alexanderjgshort/SoftDrone/hardware/Components/ANT_916_HETH_3D/ANT-916-HETH.STEP

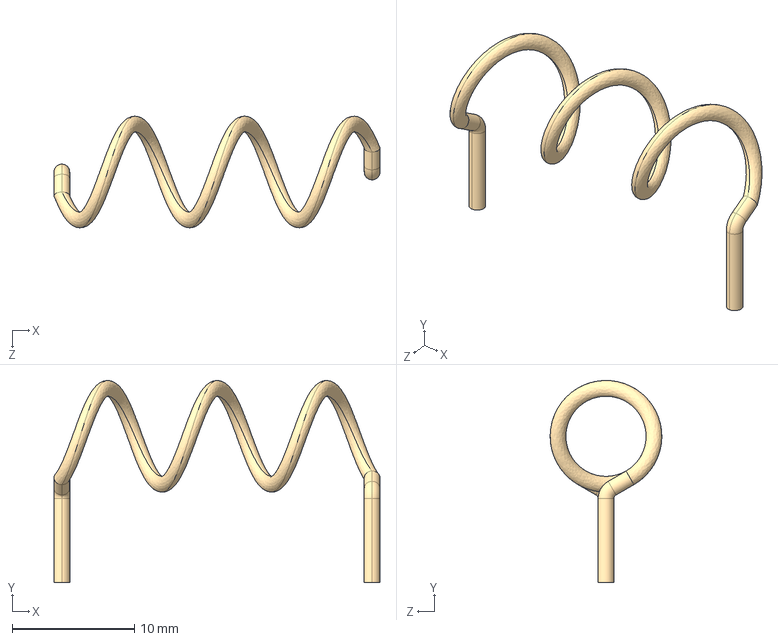
[picture p1: CAD file, 2026-09-10]
hardware/Components/ANT_916_HETH_3D/ANT-916-HETH.STEP
26.7 x 16.5 x 9.14 mm
