alexanderjgshort/SoftDrone/hardware/Components/F330 low plate(1)/F330 low plate - Part 1.step

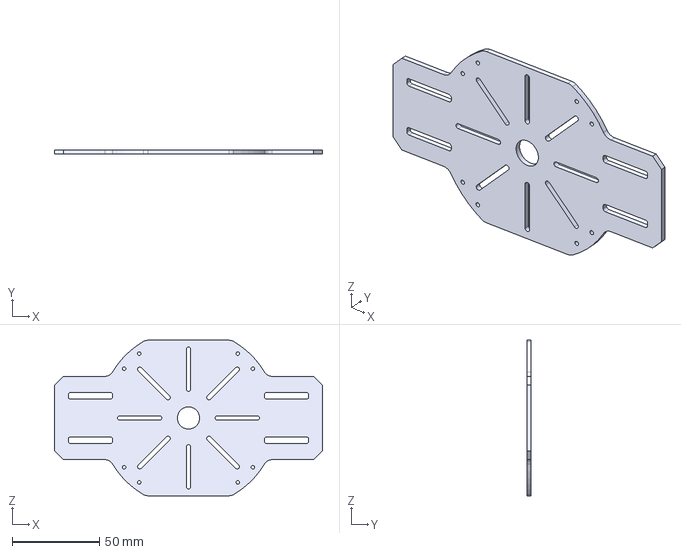
[picture p2: CAD file, 2026-09-12]
hardware/Components/F330 low plate(1)/F330 low plate - Part 1.step
153.2 x 2.54 x 88.9 mm
