alexanderjgshort/SoftDrone/hardware/Components/HRO_TYPE-C-31-M-12.step

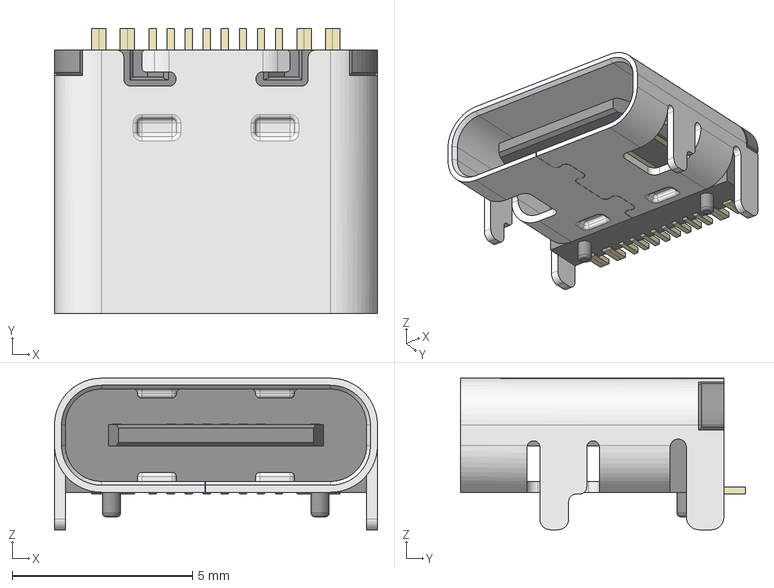
[picture p3: CAD file, 2026-09-13]
hardware/Components/HRO_TYPE-C-31-M-12.step
8.95 x 7.90 x 4.20 mm
