alexanderjgshort/SoftDrone/hardware/Components/LIB_6DFN36CA-M3_I/6DFN36CA-M3_I/3D/6DFN36CA-M3_I.stp

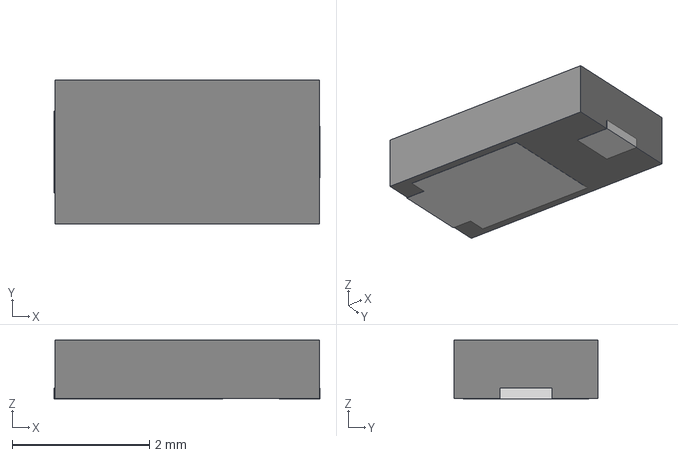
[picture p4: CAD file, 2026-09-13]
hardware/Components/LIB_6DFN36CA-M3_I/6DFN36CA-M3_I/3D/6DFN36CA-M3_I.stp
3.87 x 2.10 x 0.854 mm
