alexanderjgshort/SoftDrone/hardware/Components/LIB_ANT-916-HETH/ANT-916-HETH/3D/ANT-916-HETH.stp

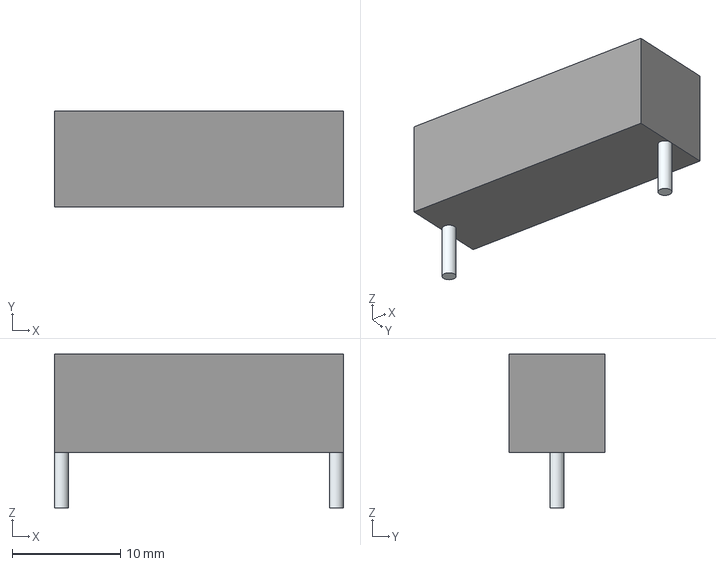
[picture p5: CAD file, 2026-09-09]
hardware/Components/LIB_ANT-916-HETH/ANT-916-HETH/3D/ANT-916-HETH.stp
26.7 x 8.90 x 14.2 mm
Leads
