alexanderjgshort/SoftDrone/hardware/Components/LIB_ANT-DB1-NSP250-T/ANT-DB1-NSP250-T/3D/ANT-DB1-NSP250-T.stp

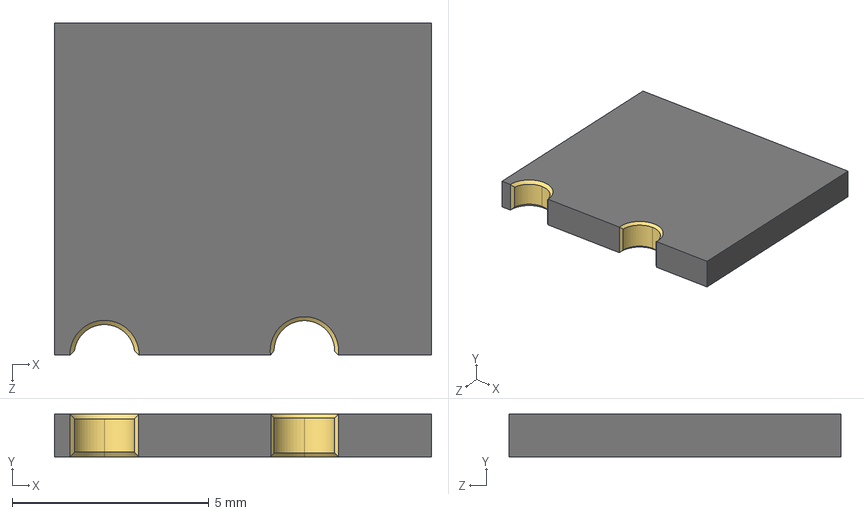
[picture p6: CAD file, 2026-09-09]
hardware/Components/LIB_ANT-DB1-NSP250-T/ANT-DB1-NSP250-T/3D/ANT-DB1-NSP250-T.stp
9.58 x 1.09 x 8.43 mm
