alexanderjgshort/SoftDrone/hardware/Components/LIB_BM08B-SRSS-TB_LF__SN_/BM08B-SRSS-TB_LF__SN_/3D/BM08B-SRSS-TB_LF__SN_.stp

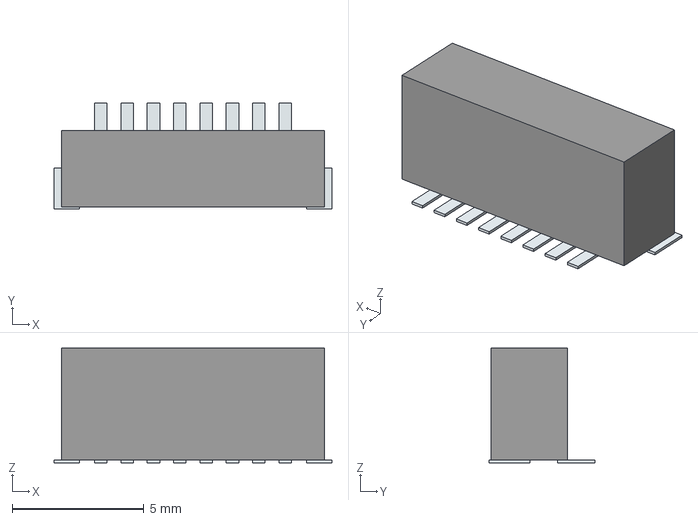
[picture p7: CAD file, 2026-09-04]
hardware/Components/LIB_BM08B-SRSS-TB_LF__SN_/BM08B-SRSS-TB_LF__SN_/3D/BM08B-SRSS-TB_LF__SN_.stp
10.6 x 4.02 x 4.35 mm
Pins
