alexanderjgshort/SoftDrone/hardware/Components/LIB_BMP581/BMP581/3D/BMP581.stp

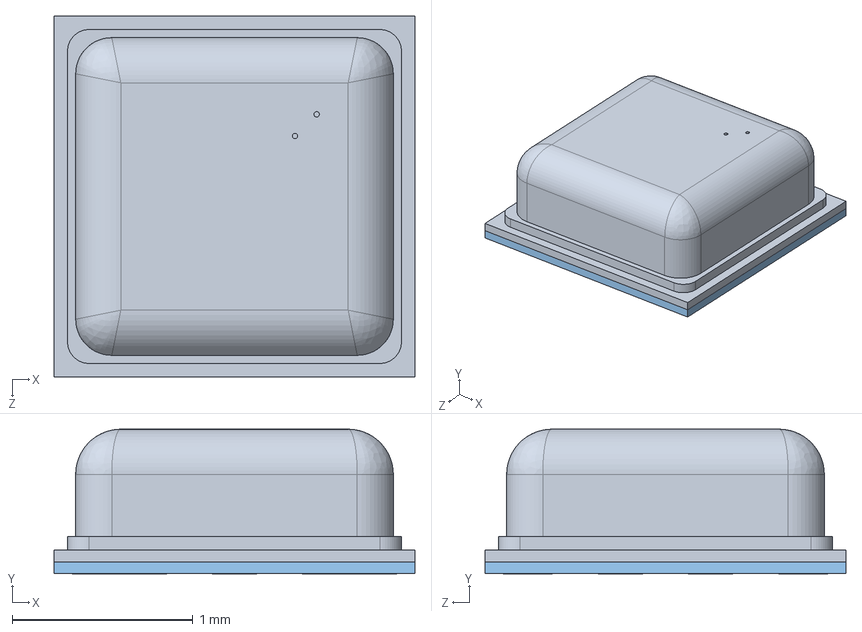
[picture p8: CAD file, 2026-09-04]
hardware/Components/LIB_BMP581/BMP581/3D/BMP581.stp
2.00 x 0.801 x 2.00 mm
