alexanderjgshort/SoftDrone/hardware/Components/LIB_CC3350ENJARSBR/CC3350ENJARSBR/3D/CC3350ENJARSBR.stp

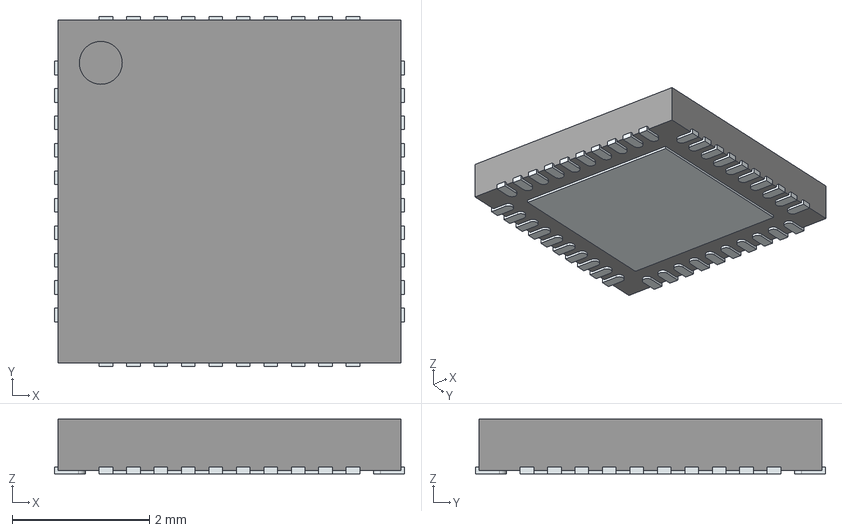
[picture p9: CAD file, 2026-09-03]
hardware/Components/LIB_CC3350ENJARSBR/CC3350ENJARSBR/3D/CC3350ENJARSBR.stp
5.10 x 5.10 x 0.8 mm
ThermalPin
PinsArrayLR
PinsArrayTB
