alexanderjgshort/SoftDrone/hardware/Components/LIB_ECMF2-40A100N6/ECMF2-40A100N6/3D/ECMF2-40A100N6.stp

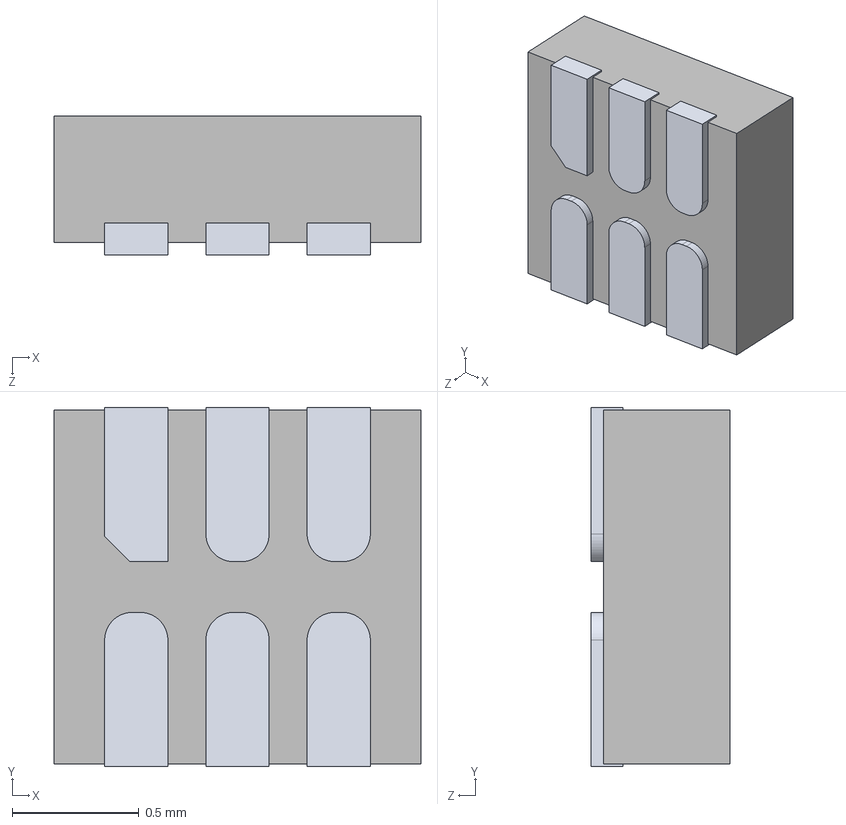
[picture p10: CAD file, 2026-09-08]
hardware/Components/LIB_ECMF2-40A100N6/ECMF2-40A100N6/3D/ECMF2-40A100N6.stp
1.45 x 1.42 x 0.55 mm
