alexanderjgshort/SoftDrone/hardware/Components/LIB_FC-135R_32.7680KA-A3/FC-135R_32.7680KA-A3/3D/FC-135R_32.7680KA-A3.stp

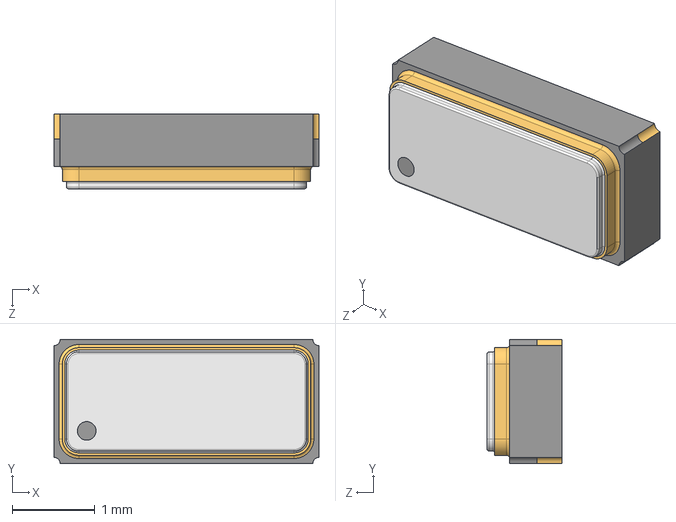
[picture p11: CAD file, 2026-09-24]
hardware/Components/LIB_FC-135R_32.7680KA-A3/FC-135R_32.7680KA-A3/3D/FC-135R_32.7680KA-A3.stp
3.20 x 1.50 x 0.9 mm
