alexanderjgshort/SoftDrone/hardware/Components/LIB_ICM-42688-P/ICM-42688-P/3D/ICM-42688-P.stp

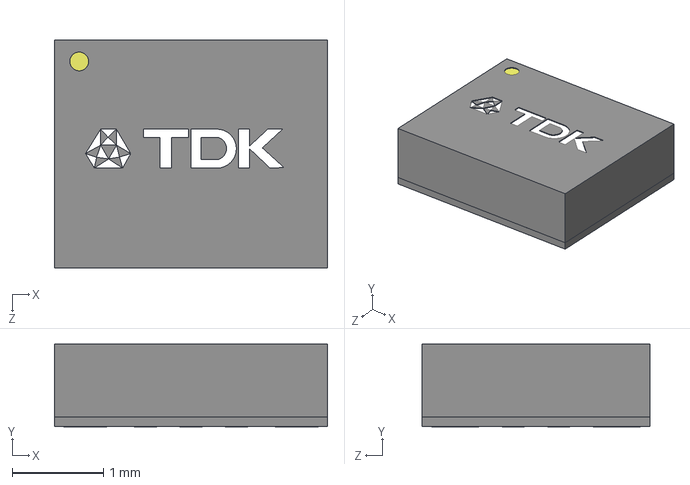
[picture p12: CAD file, 2026-09-03]
hardware/Components/LIB_ICM-42688-P/ICM-42688-P/3D/ICM-42688-P.stp
3.00 x 0.91 x 2.50 mm
