alexanderjgshort/SoftDrone/hardware/Components/LIB_LM4670ITL_NOPB/LM4670ITL_NOPB/3D/LM4670ITL_NOPB.stp

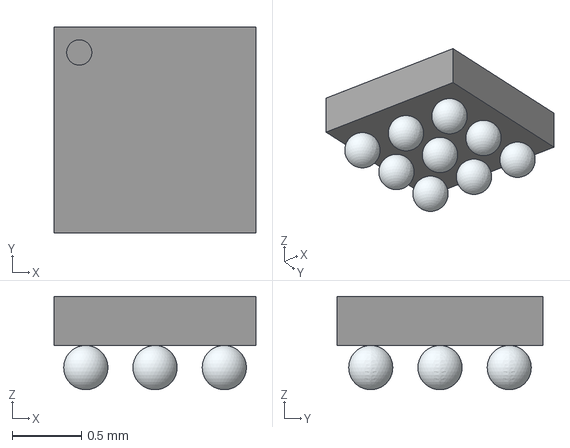
[picture p13: CAD file, 2026-09-09]
hardware/Components/LIB_LM4670ITL_NOPB/LM4670ITL_NOPB/3D/LM4670ITL_NOPB.stp
1.46 x 1.48 x 0.675 mm
