alexanderjgshort/SoftDrone/hardware/Components/LIB_LP5907A28YKMR/LP5907A28YKMR/3D/LP5907A28YKMR.stp

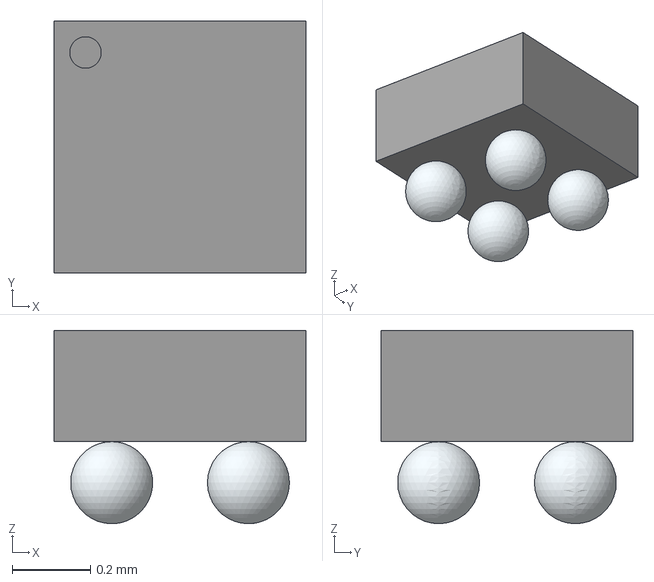
[picture p14: CAD file, 2026-09-08]
hardware/Components/LIB_LP5907A28YKMR/LP5907A28YKMR/3D/LP5907A28YKMR.stp
0.645 x 0.645 x 0.495 mm
