alexanderjgshort/SoftDrone/hardware/Components/LIB_MM8030-2610RJ3/MM8030-2610RJ3/3D/MM8030-2610RJ3.stp

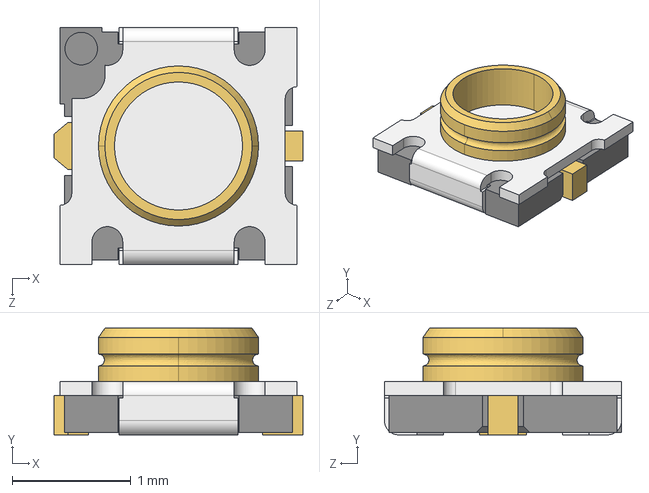
[picture p15: CAD file, 2026-09-07]
hardware/Components/LIB_MM8030-2610RJ3/MM8030-2610RJ3/3D/MM8030-2610RJ3.stp
2.10 x 0.9 x 2.00 mm
