alexanderjgshort/SoftDrone/hardware/Components/LIB_MX25UW25645GXDI00-TR/MX25UW25645GXDI00-TR/3D/MX25UW25645GXDI00-TR.stp

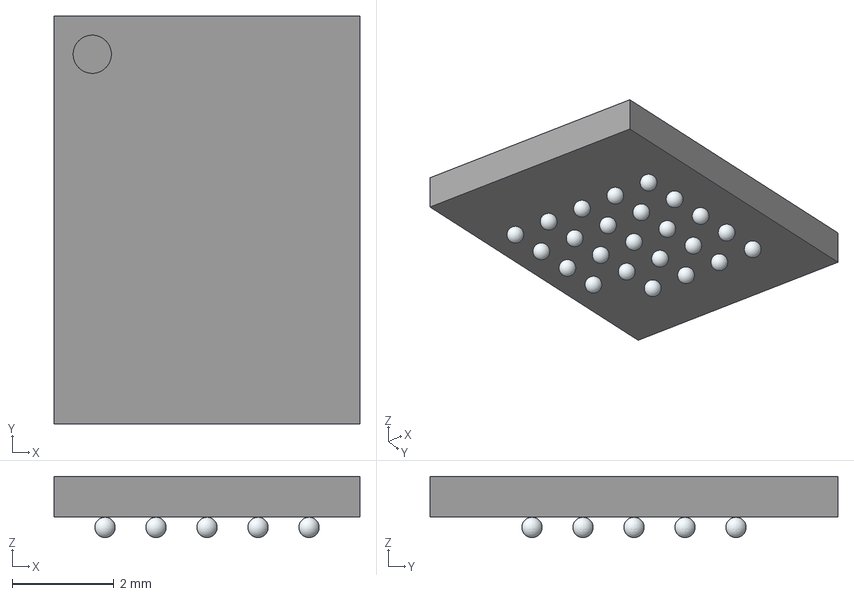
[picture p16: CAD file, 2026-09-02]
hardware/Components/LIB_MX25UW25645GXDI00-TR/MX25UW25645GXDI00-TR/3D/MX25UW25645GXDI00-TR.stp
6.00 x 8.00 x 1.20 mm
A2
A3
A4
A5
B1
B2
B3
B4
B5
C1
C2
C3
C4
C5
D1
D2
D3
D4
D5
E1
E2
E3
E4
E5
