alexanderjgshort/SoftDrone/hardware/Components/LIB_PE4259-63/PE4259-63/3D/PE4259-63.stp

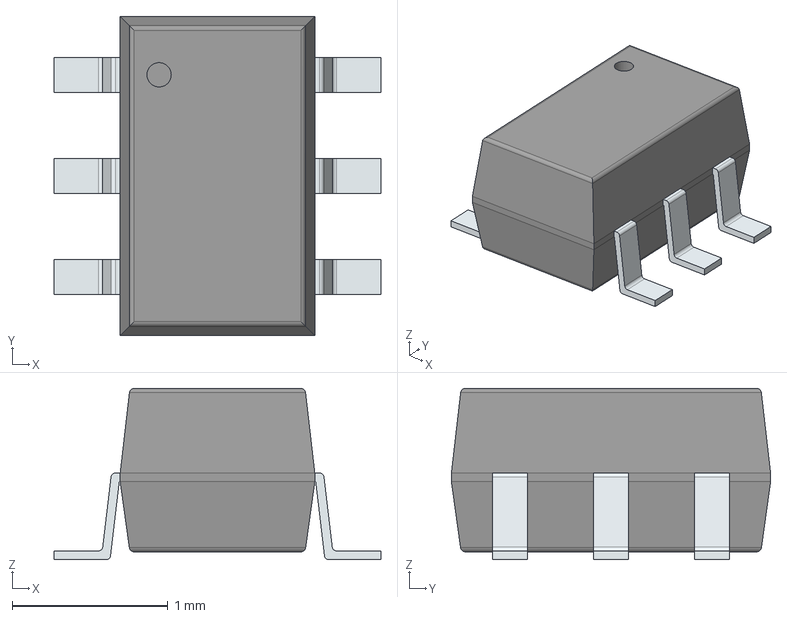
[picture p17: CAD file, 2026-09-08]
hardware/Components/LIB_PE4259-63/PE4259-63/3D/PE4259-63.stp
2.10 x 2.05 x 1.10 mm
PinsArrayLR
