alexanderjgshort/SoftDrone/hardware/Components/LIB_SAM-M10Q/SAM-M10Q/3D/SAM-M10Q.stp

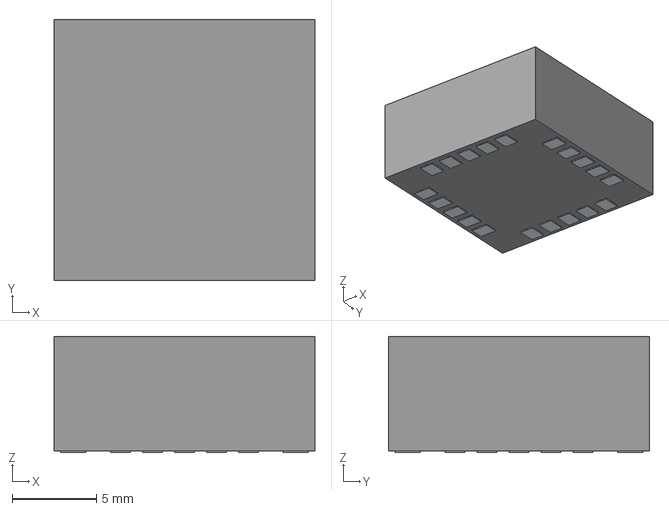
[picture p18: CAD file, 2026-09-03]
hardware/Components/LIB_SAM-M10Q/SAM-M10Q/3D/SAM-M10Q.stp
15.5 x 15.5 x 6.90 mm
Pins
