alexanderjgshort/SoftDrone/hardware/Components/LIB_SQA411CEJW-T1_GE3/SQA411CEJW-T1_GE3/3D/SQA411CEJW-T1_GE3.stp

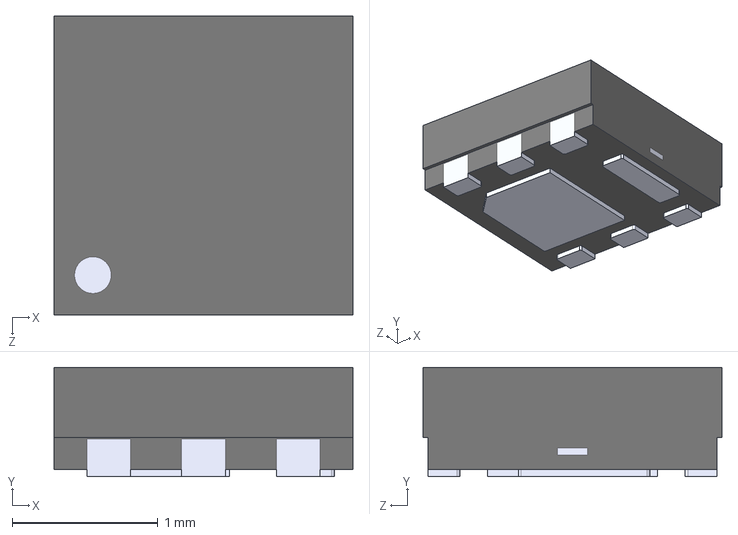
[picture p19: CAD file, 2026-09-11]
hardware/Components/LIB_SQA411CEJW-T1_GE3/SQA411CEJW-T1_GE3/3D/SQA411CEJW-T1_GE3.stp
2.05 x 0.75 x 2.05 mm
