alexanderjgshort/SoftDrone/hardware/Components/LIB_STM32N645I0H3Q/STM32N645I0H3Q/3D/STM32N645I0H3Q.stp

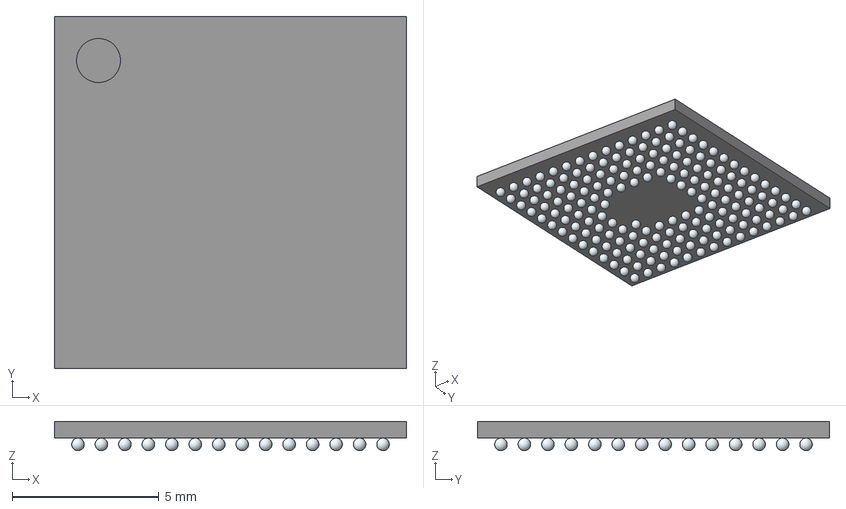
[picture p20: CAD file, 2026-09-01]
hardware/Components/LIB_STM32N645I0H3Q/STM32N645I0H3Q/3D/STM32N645I0H3Q.stp
12.0 x 12.0 x 1.00 mm
A1
A2
A3
A4
A5
A6
A7
A8
A9
A10
A11
A12
A13
A14
B1
B2
B3
B4
B5
B6
B7
B8
B9
B10
B11
B12
B13
B14
C1
C2
C3
C4
C5
C6
C7
C8
C9
C10
C11
C12
C13
C14
D1
D2
D3
D4
D5
D6
D7
D8
D9
D10
D11
D12
D13
D14
E1
E2
E3
E4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
