alexanderjgshort/SoftDrone/hardware/Components/LIB_SX1262IMLTRT/SX1262IMLTRT/3D/SX1262IMLTRT.stp

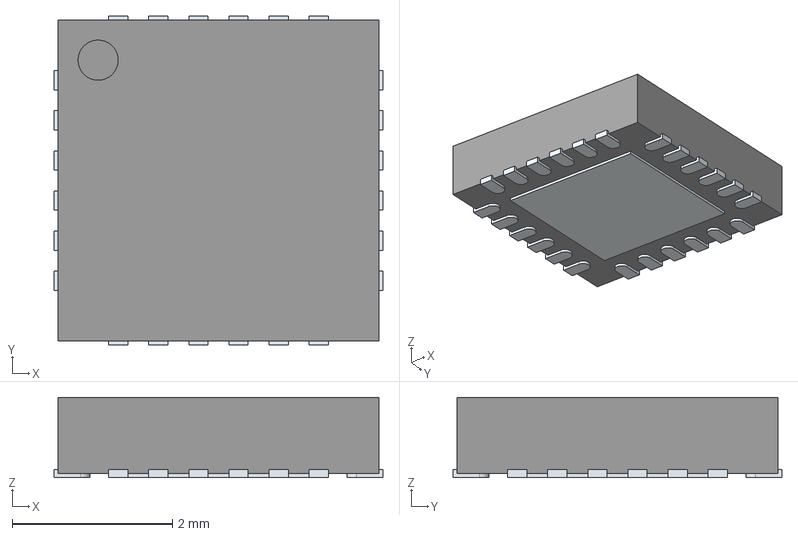
[picture p21: CAD file, 2026-09-10]
hardware/Components/LIB_SX1262IMLTRT/SX1262IMLTRT/3D/SX1262IMLTRT.stp
4.10 x 4.10 x 1.00 mm
ThermalPin
PinsArrayLR
PinsArrayTB
