alexanderjgshort/SoftDrone/hardware/Components/LIB_TPS2121RUXT/TPS2121RUXT/3D/TPS2121RUXT.stp

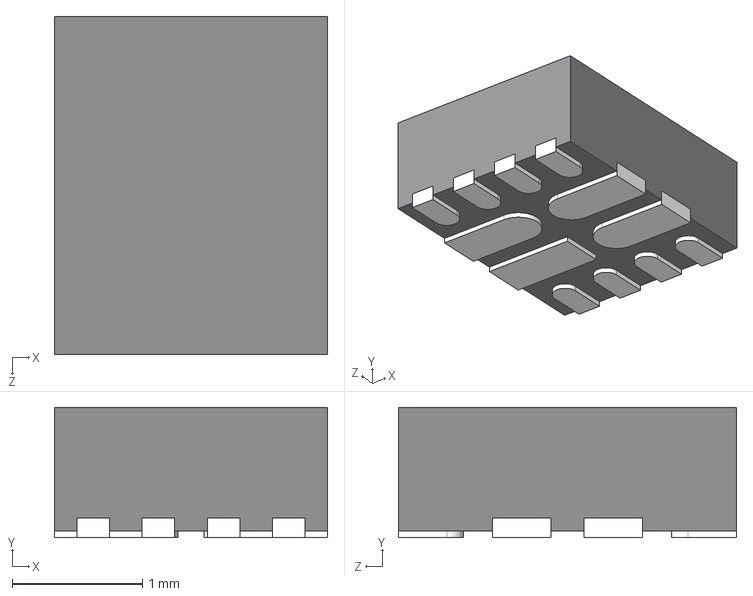
[picture p22: CAD file, 2026-09-08]
hardware/Components/LIB_TPS2121RUXT/TPS2121RUXT/3D/TPS2121RUXT.stp
2.10 x 1.00 x 2.60 mm
