alexanderjgshort/SoftDrone/hardware/Components/LIB_TXU0204BQAR/TXU0204BQAR/3D/TXU0204BQAR.stp

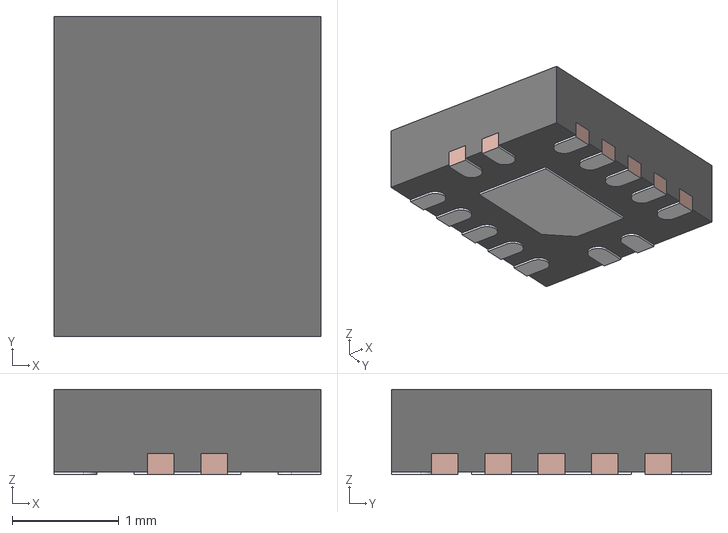
[picture p23: CAD file, 2026-09-08]
hardware/Components/LIB_TXU0204BQAR/TXU0204BQAR/3D/TXU0204BQAR.stp
2.50 x 3.00 x 0.8 mm
FRAME
