alexanderjgshort/SoftDrone/hardware/Components/ul_TPS628303ARZER_CAD/RZE0008A.stp

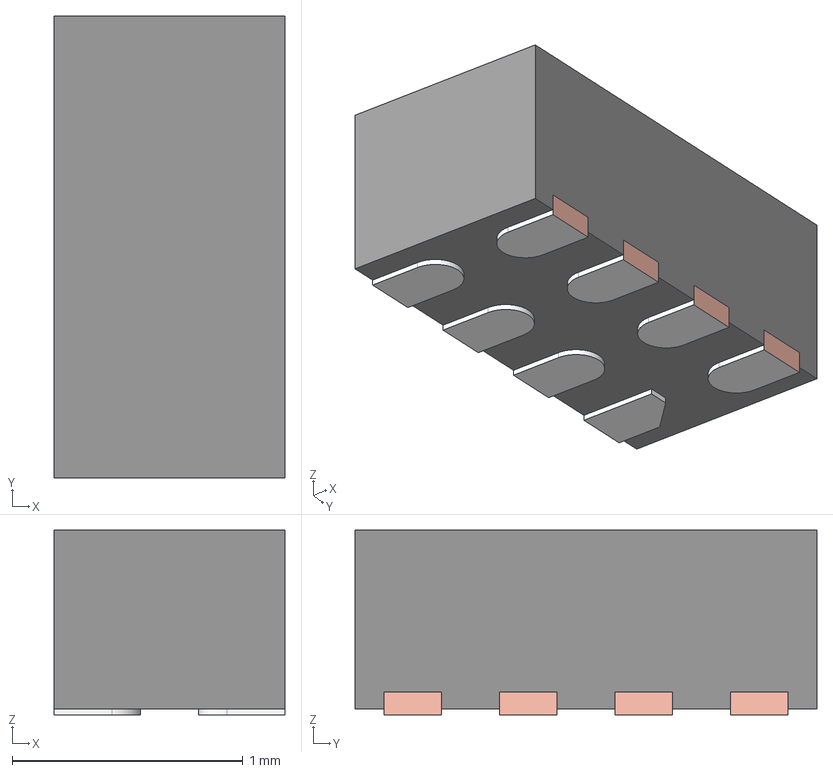
[picture p24: CAD file, 2026-09-08]
hardware/Components/ul_TPS628303ARZER_CAD/RZE0008A.stp
1.00 x 2.00 x 0.8 mm
BODY-RZE0008A
FRAME-RZE0008A
