alexanderjgshort/SoftDrone/(list of files, cad)

Other CAD files:
hardware/Components/LIB_54548-2272/54548-2272/3D/54548-2272.stp
hardware/Components/LIB_54548-2272/54548-2272/Allegro/545482272.psm
hardware/Components/LIB_54548-2272/54548-2272/DEHDL/54548_2272/chips/chips.prt
hardware/Components/LIB_6DFN36CA-M3_I/6DFN36CA-M3_I/Allegro/ss5n42hm3i.psm
hardware/Components/LIB_6DFN36CA-M3_I/6DFN36CA-M3_I/DEHDL/6dfn36ca_m3_i/chips/chips.prt
hardware/Components/LIB_74439324033/74439324033/3D/74439324033.stp
hardware/Components/LIB_74439324033/74439324033/Allegro/74439324033.psm
hardware/Components/LIB_74439324033/74439324033/DEHDL/74439324033/chips/chips.prt
hardware/Components/LIB_ANT-916-HETH/ANT-916-HETH/Allegro/ant916heth.psm
hardware/Components/LIB_ANT-916-HETH/ANT-916-HETH/DEHDL/ant_916_heth/chips/chips.prt
hardware/Components/LIB_BM08B-SRSS-TB_LF__SN_/BM08B-SRSS-TB_LF__SN_/Allegro/bm08bsrsstblfsn.psm
hardware/Components/LIB_BM08B-SRSS-TB_LF__SN_/BM08B-SRSS-TB_LF__SN_/DEHDL/bm08b_srss_tb_lf__sn_/chips/chips.prt
hardware/Components/LIB_BMP581/BMP581/Allegro/bmp581.psm
hardware/Components/LIB_BMP581/BMP581/DEHDL/bmp581/chips/chips.prt
hardware/Components/LIB_CC3350ENJARSBR/CC3350ENJARSBR/Allegro/qfn40p500x500x80-41n-d.psm
hardware/Components/LIB_CC3350ENJARSBR/CC3350ENJARSBR/DEHDL/cc3350enjarsbr/chips/chips.prt
hardware/Components/LIB_DEA162450BT-1295A1/DEA162450BT-1295A1/3D/DEA162450BT-1295A1.stp
hardware/Components/LIB_DEA162450BT-1295A1/DEA162450BT-1295A1/Allegro/dea162450bt1295a1.psm
hardware/Components/LIB_DEA162450BT-1295A1/DEA162450BT-1295A1/DEHDL/dea162450bt_1295a1/chips/chips.prt
hardware/Components/LIB_DPX167125DT-8197B1/DPX167125DT-8197B1/3D/DPX167125DT-8197B1.stp
hardware/Components/LIB_DPX167125DT-8197B1/DPX167125DT-8197B1/Allegro/dpx167125dt8197b1.psm
hardware/Components/LIB_DPX167125DT-8197B1/DPX167125DT-8197B1/DEHDL/dpx167125dt_8197b1/chips/chips.prt
hardware/Components/LIB_ECMF2-40A100N6/ECMF2-40A100N6/Allegro/ecmf240a100n6.psm
hardware/Components/LIB_ECMF2-40A100N6/ECMF2-40A100N6/DEHDL/ecmf2_40a100n6/chips/chips.prt
hardware/Components/LIB_FC-135R_32.7680KA-A3/FC-135R_32.7680KA-A3/Allegro/fc135r327680kaa3.psm
hardware/Components/LIB_FC-135R_32.7680KA-A3/FC-135R_32.7680KA-A3/DEHDL/fc_135r_32.7680ka_a3/chips/chips.prt
hardware/Components/LIB_ICM-42688-P/ICM-42688-P/Allegro/iim42352.psm
hardware/Components/LIB_ICM-42688-P/ICM-42688-P/DEHDL/icm_42688_p/chips/chips.prt
hardware/Components/LIB_LM4670ITL_NOPB/LM4670ITL_NOPB/Allegro/bga9c50p3x3_146x148x68.psm
hardware/Components/LIB_LM4670ITL_NOPB/LM4670ITL_NOPB/DEHDL/lm4670itl_nopb/chips/chips.prt
hardware/Components/LIB_LM4670SD_NOPB/LM4670SD_NOPB/Allegro/son50p300x300x80-9n.psm
hardware/Components/LIB_LM4670SD_NOPB/LM4670SD_NOPB/DEHDL/lm4670sd_nopb/chips/chips.prt
hardware/Components/LIB_LP5907A28YKMR/LP5907A28YKMR/Allegro/bga4c35p2x2_64x64x50.psm
hardware/Components/LIB_LP5907A28YKMR/LP5907A28YKMR/DEHDL/lp5907a28ykmr/chips/chips.prt
hardware/Components/LIB_MM8030-2610RJ3/MM8030-2610RJ3/Allegro/mm80302610rj3.psm
hardware/Components/LIB_MM8030-2610RJ3/MM8030-2610RJ3/DEHDL/mm8030_2610rj3/chips/chips.prt
hardware/Components/LIB_MX25UW25645GXDI00-TR/MX25UW25645GXDI00-TR/Allegro/bga24c100p5x5_600x800x120.psm
hardware/Components/LIB_MX25UW25645GXDI00-TR/MX25UW25645GXDI00-TR/DEHDL/mx25uw25645gxdi00_tr/chips/chips.prt
hardware/Components/LIB_PE4259-63/PE4259-63/Allegro/sot65p210x110-6n.psm
hardware/Components/LIB_PE4259-63/PE4259-63/DEHDL/pe4259_63/chips/chips.prt
hardware/Components/LIB_SAM-M10Q/SAM-M10Q/Allegro/samm10q.psm
hardware/Components/LIB_SAM-M10Q/SAM-M10Q/DEHDL/sam_m10q/chips/chips.prt
hardware/Components/LIB_SQA411CEJW-T1_GE3/SQA411CEJW-T1_GE3/Allegro/sqa411cejwt1_ge3.psm
hardware/Components/LIB_SQA411CEJW-T1_GE3/SQA411CEJW-T1_GE3/DEHDL/sqa411cejw_t1_ge3/chips/chips.prt
hardware/Components/LIB_STM32N645I0H3Q/STM32N645I0H3Q/Allegro/bga178c80p14x14_1200x1200x100.psm
hardware/Components/LIB_STM32N645I0H3Q/STM32N645I0H3Q/DEHDL/stm32n645i0h3q/chips/chips.prt
hardware/Components/LIB_SX1262IMLTRT/SX1262IMLTRT/Allegro/qfn50p400x400x100-25n-d.psm
hardware/Components/LIB_SX1262IMLTRT/SX1262IMLTRT/DEHDL/sx1262imltrt/chips/chips.prt
hardware/Components/LIB_TAC5112IRGER/TAC5112IRGER/Allegro/tac5112irger.psm
hardware/Components/LIB_TAC5112IRGER/TAC5112IRGER/DEHDL/tac5112irger/chips/chips.prt
hardware/Components/LIB_TFM201610ALC-R47MTAA/TFM201610ALC-R47MTAA/3D/TFM201610ALC-R47MTAA.stp
hardware/Components/LIB_TFM201610ALC-R47MTAA/TFM201610ALC-R47MTAA/Allegro/indc2016x80n.psm
hardware/Components/LIB_TFM201610ALC-R47MTAA/TFM201610ALC-R47MTAA/DEHDL/tfm201610alc_r47mtaa/chips/chips.prt
hardware/Components/LIB_TPS2121RUXT/TPS2121RUXT/Allegro/tps2121ruxt.psm
hardware/Components/LIB_TPS2121RUXT/TPS2121RUXT/DEHDL/tps2121ruxt/chips/chips.prt
hardware/Components/LIB_TPS7A2118PQWDRBRQ1/TPS7A2118PQWDRBRQ1/Allegro/son65p300x300x100-9n-d.psm
hardware/Components/LIB_TPS7A2118PQWDRBRQ1/TPS7A2118PQWDRBRQ1/DEHDL/tps7a2118pqwdrbrq1/chips/chips.prt
hardware/Components/LIB_TXU0204BQAR/TXU0204BQAR/Allegro/txu0204bqar.psm
hardware/Components/LIB_TXU0204BQAR/TXU0204BQAR/DEHDL/txu0204bqar/chips/chips.prt
