alexanderjgshort/SoftDrone/(list of files, drawings)

Other design files:
hardware/Components/LIB_TPS7A2118PQWDRBRQ1/TPS7A2118PQWDRBRQ1/Altium/SON65P300X300X100-9N-D.PcbLib
hardware/Components/LIB_TPS7A2118PQWDRBRQ1/TPS7A2118PQWDRBRQ1/Altium/TPS7A2118PQWDRBRQ1.SchLib
