alexanderjgshort/SoftDrone/hardware/drone/_restore_backup_2026-09-17T12-52-13-706/drone.kicad_pcb

## KiCad design hardware/drone/_restore_backup_2026-09-17T12-52-13-706/drone.kicad_pcb (2026-09-16)

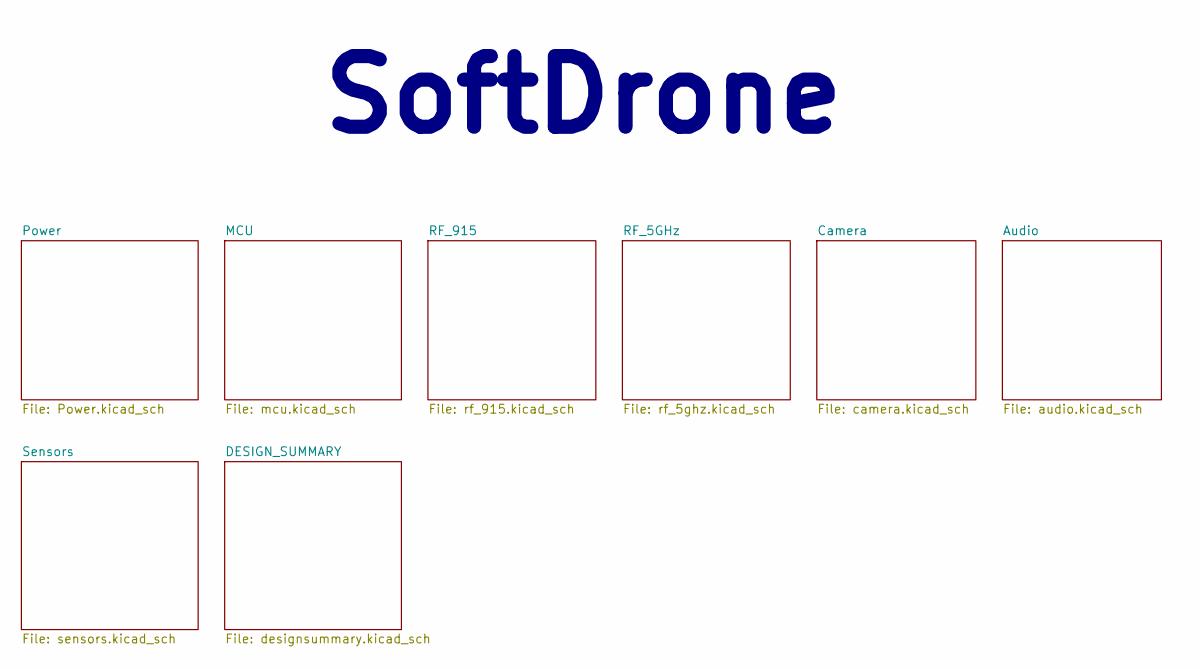
[picture p25: schematic drone.kicad_sch]

Notes on the sheet:
SoftDrone

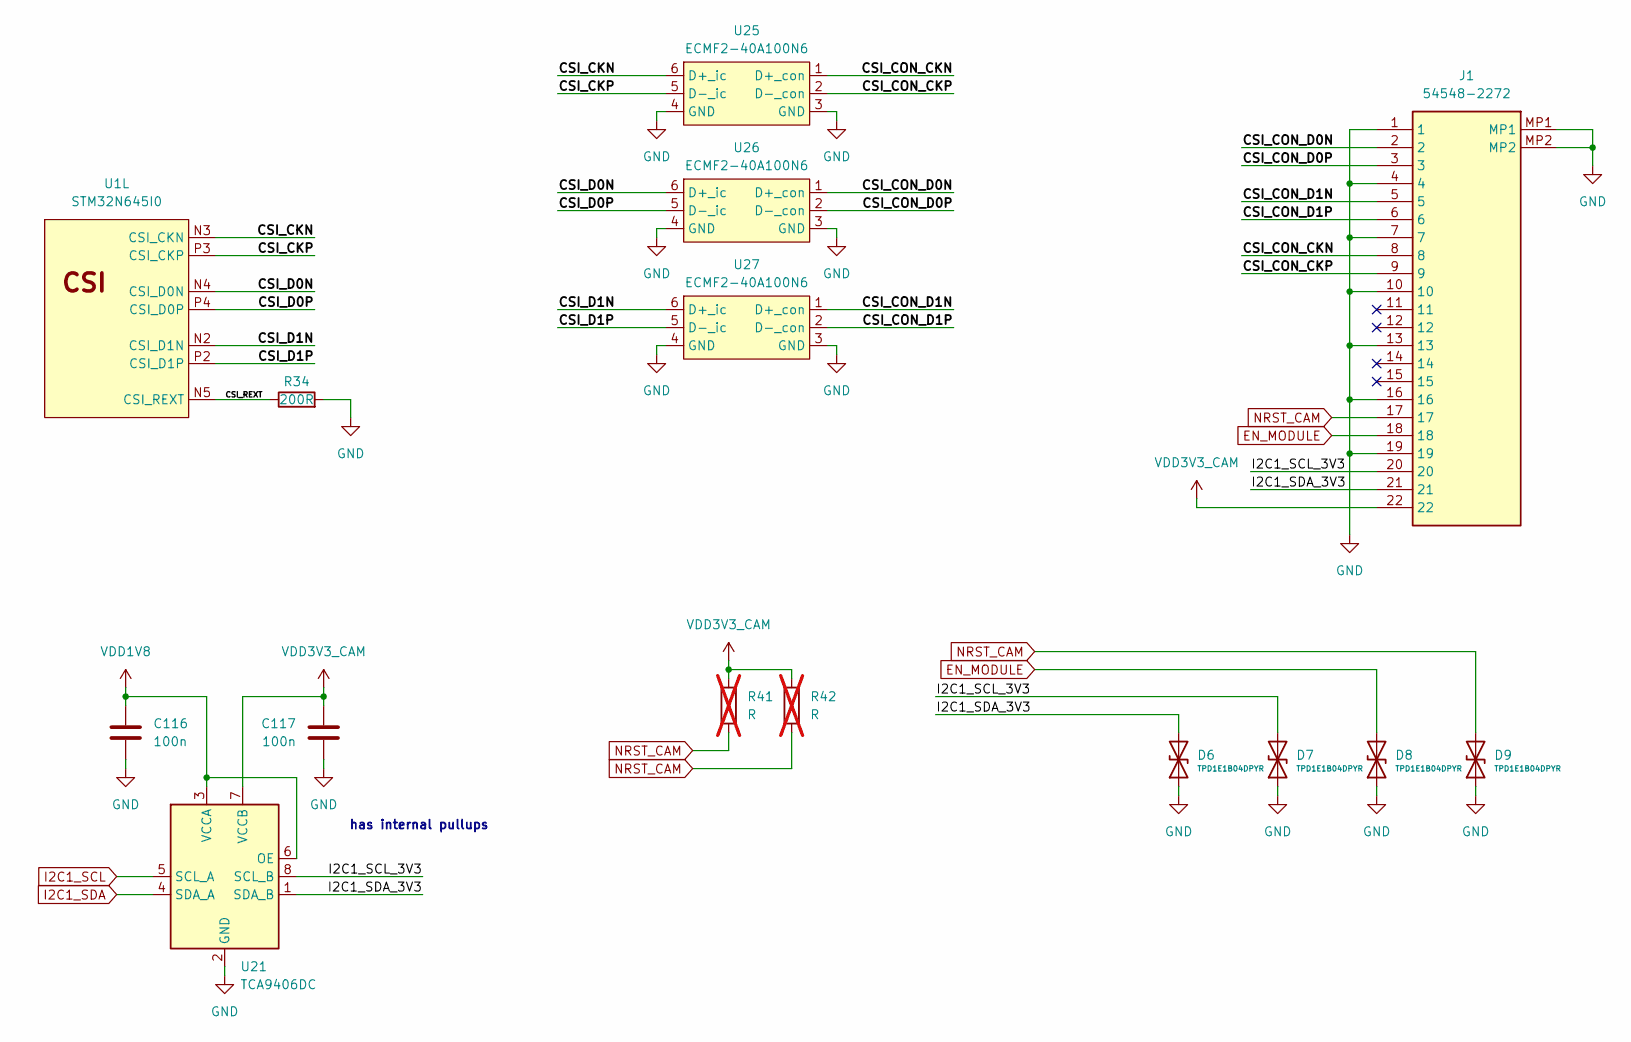
[picture p26: schematic camera.kicad_sch]

Parts:
C116, C117: 100n; C_0402_1005Metric
D6, D7, D8, D9: TPD1E1B04DPYR
J1: 54548-2272; 545482272; Manufacturer_Part_Number 54548-2272; Mouser Part Number 538-54548-2272
R34: 200R; R_0402_1005Metric
R41, R42: R; R_0603_1608Metric; not fitted
U1: STM32N645I0; BGA178C80P14X14_1200X1200X100
U21: TCA9406DC; VSSOP-8_2.3x2mm_P0.5mm
U25, U26, U27: ECMF2-40A100N6

Connections:
/Camera/CSI_CKN: U1.N3 (CSI_CKN), U25.6 (D+_ic)
/Camera/CSI_CKP: U1.P3 (CSI_CKP), U25.5 (D-_ic)
/Camera/CSI_CON_CKN: J1.8, U25.1 (D+_con)
/Camera/CSI_CON_CKP: J1.9, U25.2 (D-_con)
/Camera/CSI_CON_D0N: J1.2, U26.1 (D+_con)
/Camera/CSI_CON_D0P: J1.3, U26.2 (D-_con)
/Camera/CSI_CON_D1N: J1.5, U27.1 (D+_con)
/Camera/CSI_CON_D1P: J1.6, U27.2 (D-_con)
/Camera/CSI_D0N: U1.N4 (CSI_D0N), U26.6 (D+_ic)
/Camera/CSI_D0P: U1.P4 (CSI_D0P), U26.5 (D-_ic)
/Camera/CSI_D1N: U1.N2 (CSI_D1N), U27.6 (D+_ic)
/Camera/CSI_D1P: U1.P2 (CSI_D1P), U27.5 (D-_ic)
/Camera/CSI_REXT: R34.1, U1.N5 (CSI_REXT)
/Camera/I2C1_SCL_3V3: D7.2 (A2), J1.20, U21.8 (SCL_B)
/Camera/I2C1_SDA_3V3: D6.2 (A2), J1.21, U21.1 (SDA_B)
EN_MODULE: D8.2 (A2), J1.18; also elsewhere on the board
GND: C116.2, C117.2, D6.1 (A1), D7.1 (A1), D8.1 (A1), D9.1 (A1), J1.1, J1.4, J1.7, J1.10, J1.13, J1.16, J1.19, J1.MP1, J1.MP2, R34.2, U21.2 (GND), U25.3 (GND), U25.4 (GND), U26.3 (GND), U26.4 (GND), U27.3 (GND), U27.4 (GND); also elsewhere on the board
I2C1_SCL: U21.5 (SCL_A); also elsewhere on the board
I2C1_SDA: U21.4 (SDA_A); also elsewhere on the board
NRST_CAM: D9.2 (A2), J1.17, R41.2, R42.2; also elsewhere on the board
VDD1V8: C116.1, U21.3 (VCCA), U21.6 (OE); also elsewhere on the board
VDD3V3_CAM: C117.1, J1.22, R41.1, R42.1, U21.7 (VCCB); also elsewhere on the board

Notes on the sheet:
has internal pullups

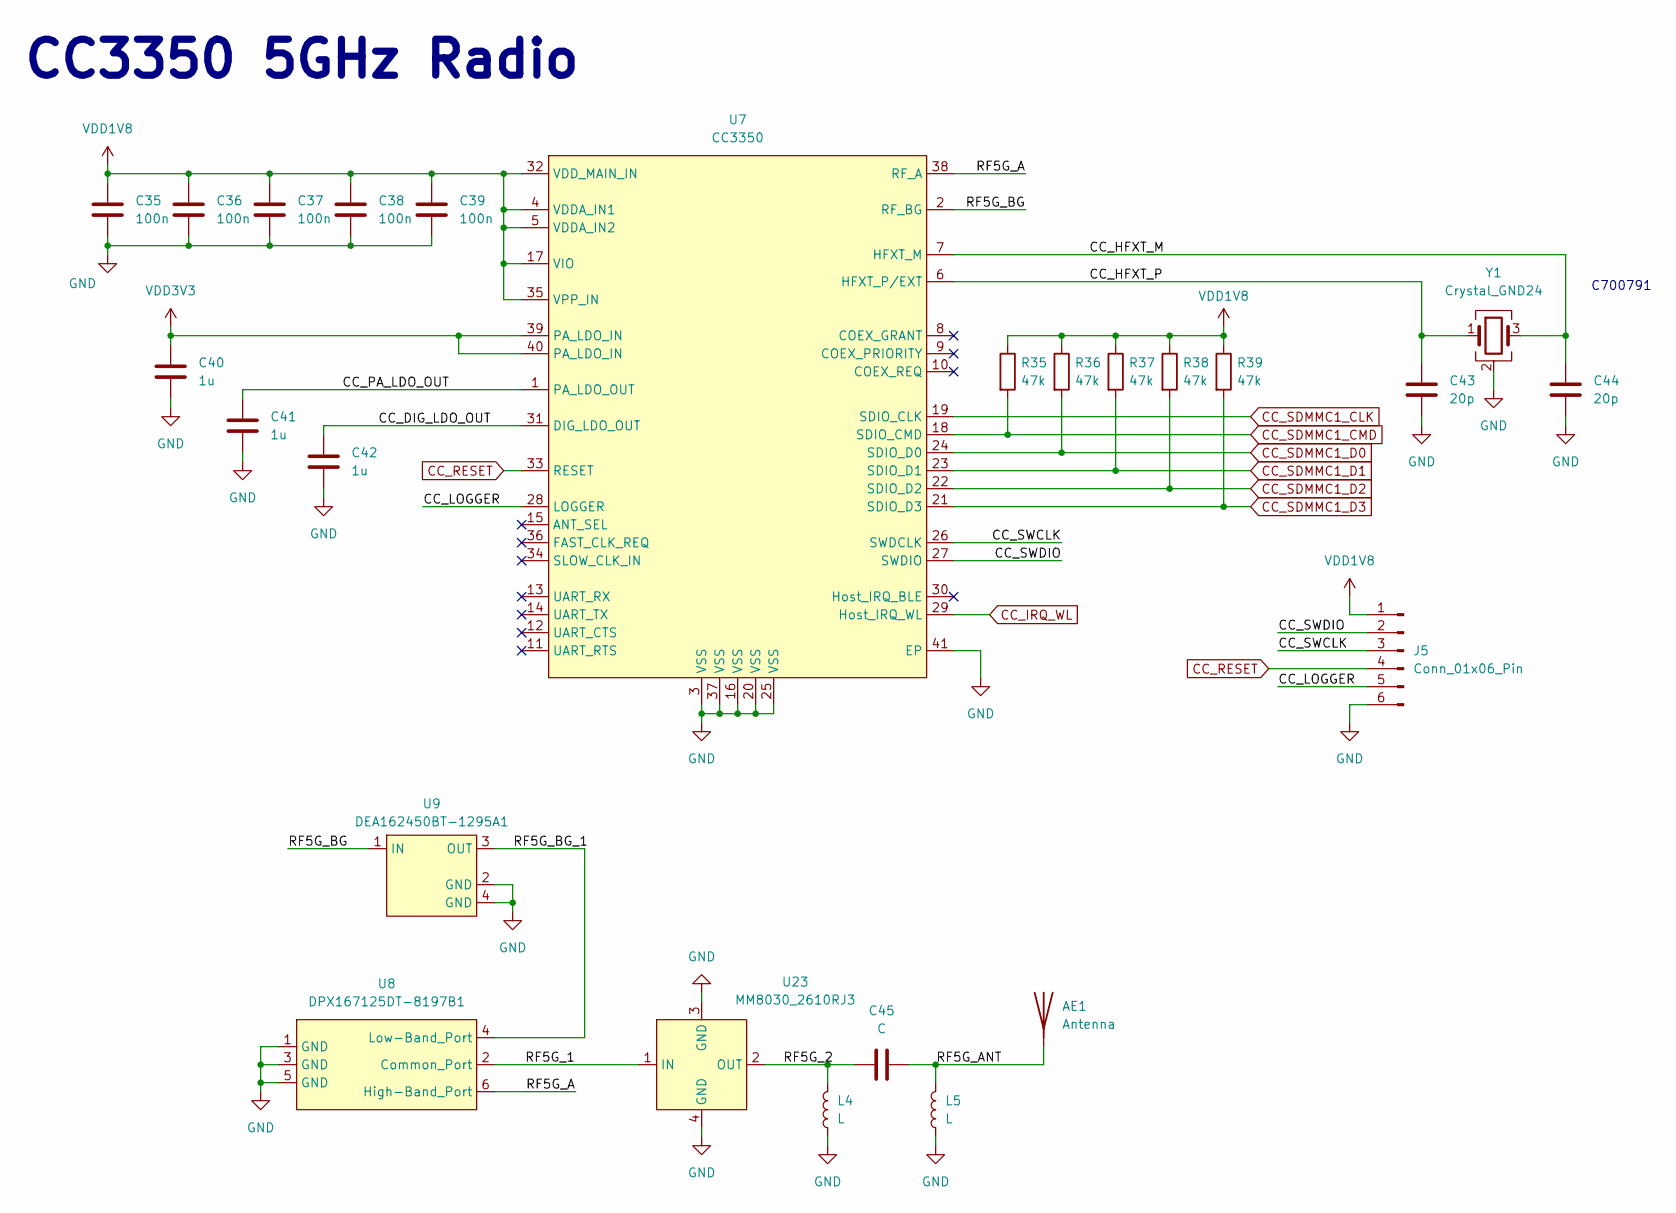
[picture p27: schematic rf_5ghz.kicad_sch]

Parts:
AE1: Antenna; ANT-DB1-NSP250-T
C35, C36, C37, C38, C39: 100n; C_0201_0603Metric
C40, C41: 1u; C_0201_0603Metric
C42: 1u; C_0402_1005Metric
C43, C44: 20p; C_0201_0603Metric
C45: C; C_0603_1608Metric
J5: Conn_01x06_Pin; PinHeader_1x06_P2.54mm_Vertical
L4, L5: L; L_0603_1608Metric
R35, R36, R37, R38, R39: 47k; R_0201_0603Metric
U7: CC3350; QFN40P500X500X80-41N-D
U8: DPX167125DT-8197B1; DPX167125DT8197B1
U9: DEA162450BT-1295A1; DEA162450BT1295A1
U23: MM8030_2610RJ3; MM8030-2610RJ3
Y1: Crystal_GND24; Crystal_SMD_3225-4Pin_3.2x2.5mm

Connections:
/RF_5GHz/CC_DIG_LDO_OUT: C42.1, U7.31 (DIG_LDO_OUT)
/RF_5GHz/CC_HFXT_M: C44.1, U7.7 (HFXT_M), Y1.3
/RF_5GHz/CC_HFXT_P: C43.1, U7.6 (HFXT_P/EXT), Y1.1
/RF_5GHz/CC_LOGGER: J5.5, U7.28 (LOGGER)
/RF_5GHz/CC_PA_LDO_OUT: C41.1, U7.1 (PA_LDO_OUT)
/RF_5GHz/CC_SWCLK: J5.3, U7.26 (SWDCLK)
/RF_5GHz/CC_SWDIO: J5.2, U7.27 (SWDIO)
/RF_5GHz/RF5G_1: U8.2 (Common_Port), U23.1 (IN)
/RF_5GHz/RF5G_2: C45.1, L4.2, U23.2 (OUT)
/RF_5GHz/RF5G_A: U7.38 (RF_A), U8.6 (High-Band_Port)
/RF_5GHz/RF5G_ANT: AE1.1 (A_1), C45.2, L5.2
/RF_5GHz/RF5G_BG: U7.2 (RF_BG), U9.1 (IN)
/RF_5GHz/RF5G_BG_1: U8.4 (Low-Band_Port), U9.3 (OUT)
CC_IRQ_WL: U7.29 (Host_IRQ_WL); also elsewhere on the board
CC_RESET: J5.4, U7.33 (RESET); also elsewhere on the board
CC_SDMMC1_CLK: U7.19 (SDIO_CLK); also elsewhere on the board
CC_SDMMC1_CMD: R35.2, U7.18 (SDIO_CMD); also elsewhere on the board
CC_SDMMC1_D0: R36.2, U7.24 (SDIO_D0); also elsewhere on the board
CC_SDMMC1_D1: R37.2, U7.23 (SDIO_D1); also elsewhere on the board
CC_SDMMC1_D2: R38.2, U7.22 (SDIO_D2); also elsewhere on the board
CC_SDMMC1_D3: R39.2, U7.21 (SDIO_D3); also elsewhere on the board
GND: C35.2, C36.2, C37.2, C38.2, C39.2, C40.2, C41.2, C42.2, C43.2, C44.2, J5.6, L4.1, L5.1, U7.3 (VSS), U7.16 (VSS), U7.20 (VSS), U7.25 (VSS), U7.37 (VSS), U7.41 (EP), U8.1 (GND), U8.3 (GND), U8.5 (GND), U9.2 (GND), U9.4 (GND), U23.3 (GND), U23.4 (GND), Y1.2 (G), Y1.4 (G); also elsewhere on the board
VDD1V8: C35.1, C36.1, C37.1, C38.1, C39.1, J5.1, R35.1, R36.1, R37.1, R38.1, R39.1, U7.4 (VDDA_IN1), U7.5 (VDDA_IN2), U7.17 (VIO), U7.32 (VDD_MAIN_IN), U7.35 (VPP_IN); also elsewhere on the board
VDD3V3: C40.1, U7.39 (PA_LDO_IN), U7.40 (PA_LDO_IN); also elsewhere on the board

Notes on the sheet:
CC3350 5GHz Radio
C700791

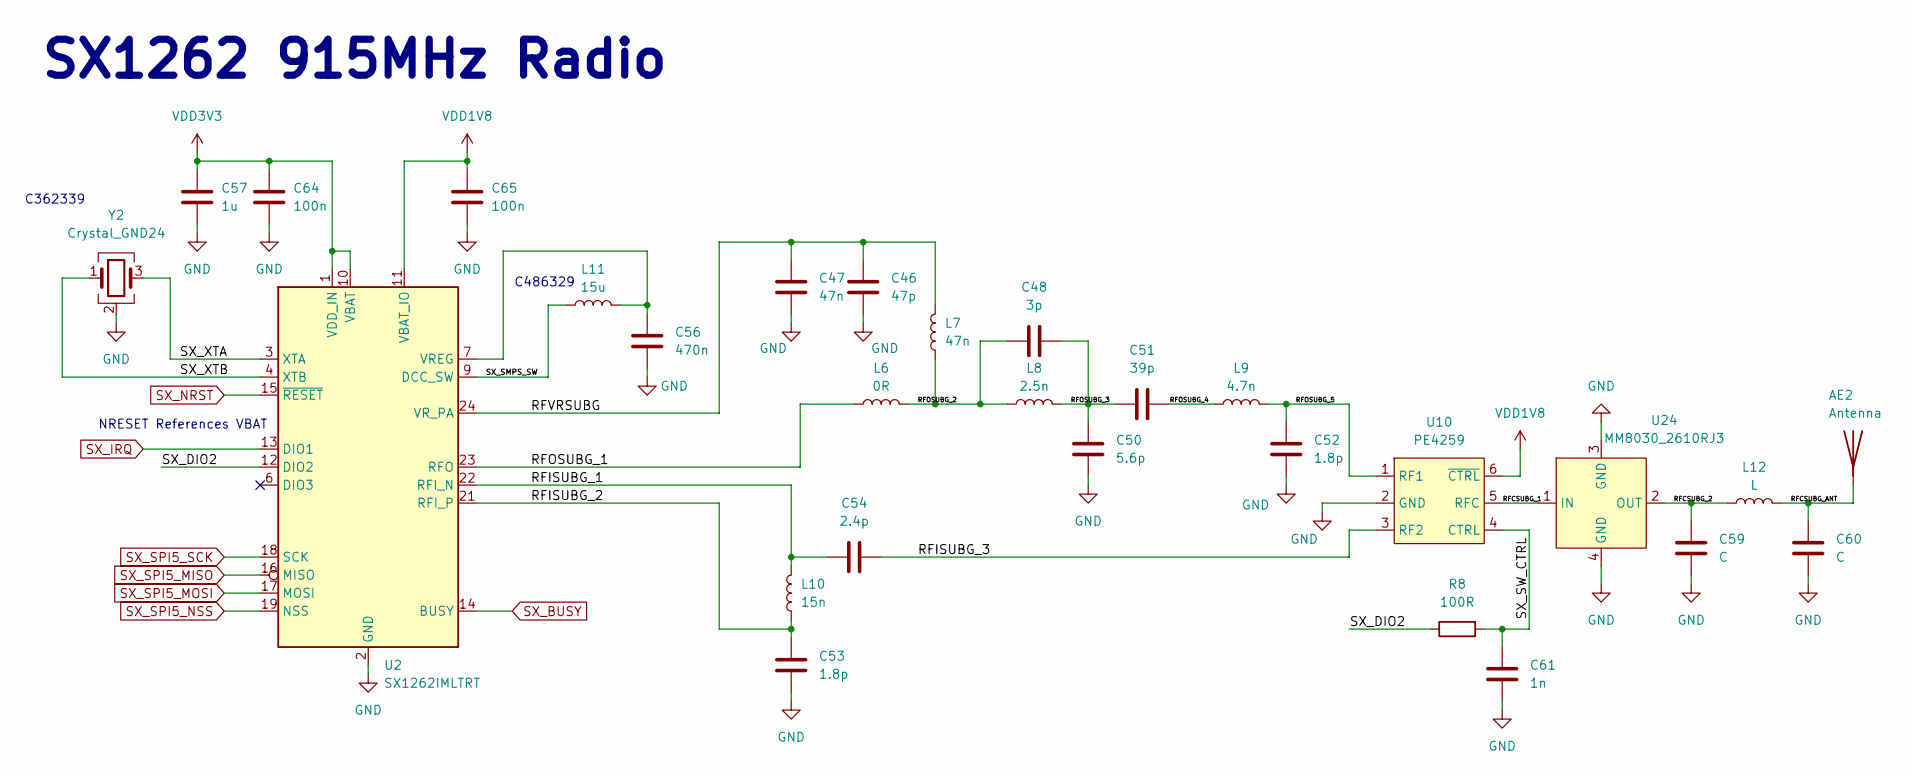
[picture p28: schematic rf_915.kicad_sch]

Parts:
AE2: Antenna; ANT916HETH
C46: 47p; C_0402_1005Metric
C47: 47n; C_0402_1005Metric
C48: 3p; C_0402_1005Metric
C50: 5.6p; C_0402_1005Metric
C51: 39p; C_0402_1005Metric
C52, C53: 1.8p; C_0402_1005Metric
C54: 2.4p; C_0402_1005Metric
C56: 470n; C_0402_1005Metric
C57: 1u; C_0201_0603Metric
C59, C60: C; C_0603_1608Metric
C61: 1n; C_0402_1005Metric
C64, C65: 100n; C_0201_0603Metric
L6: 0R; L_0402_1005Metric
L7: 47n; L_0402_1005Metric
L8: 2.5n; L_0402_1005Metric
L9: 4.7n; L_0402_1005Metric
L10: 15n; L_0402_1005Metric
L11: 15u; L_0603_1608Metric
L12: L; L_0603_1608Metric
R8: 100R; R_0402_1005Metric
U2: SX1262IMLTRT; QFN-24-1EP_4x4mm_P0.5mm_EP2.7x2.7mm
U10: PE4259
U24: MM8030_2610RJ3; MM8030-2610RJ3
Y2: Crystal_GND24; Crystal_SMD_3225-4Pin_3.2x2.5mm

Connections:
/RF_915/RFCSUBG_1: U10.5 (RFC), U24.1 (IN)
/RF_915/RFCSUBG_2: C59.2, L12.1, U24.2 (OUT)
/RF_915/RFCSUBG_ANT: AE2.1 (A_1), C60.2, L12.2
/RF_915/RFISUBG_1: C54.2, L10.2, U2.22 (RFI_N)
/RF_915/RFISUBG_2: C53.2, L10.1, U2.21 (RFI_P)
/RF_915/RFISUBG_3: C54.1, U10.3 (RF2)
/RF_915/RFOSUBG_1: L6.1, U2.23 (RFO)
/RF_915/RFOSUBG_2: C48.1, L6.2, L7.1, L8.1
/RF_915/RFOSUBG_3: C48.2, C50.1, C51.1, L8.2
/RF_915/RFOSUBG_4: C51.2, L9.1
/RF_915/RFOSUBG_5: C52.2, L9.2, U10.1 (RF1)
/RF_915/RFVRSUBG: C46.1, C47.1, L7.2, U2.24 (VR_PA)
/RF_915/SX_DIO2: R8.1, U2.12 (DIO2)
/RF_915/SX_SMPS_SW: L11.1, U2.9 (DCC_SW)
/RF_915/SX_SW_CTRL: C61.2, R8.2, U10.4 (CTRL)
/RF_915/SX_XTA: U2.3 (XTA), Y2.3
/RF_915/SX_XTB: U2.4 (XTB), Y2.1
GND: C46.2, C47.2, C50.2, C52.1, C53.1, C56.2, C57.2, C59.1, C60.1, C61.1, C64.2, C65.2, U2.2 (GND), U2.5 (GND), U2.8 (GND), U2.20 (GND), U2.25 (GND), U10.2 (GND), U24.3 (GND), U24.4 (GND), Y2.2 (G), Y2.4 (G); also elsewhere on the board
unnamed: C56.1, L11.2, U2.7 (VREG)
SX_BUSY: U2.14 (BUSY); also elsewhere on the board
SX_IRQ: U2.13 (DIO1); also elsewhere on the board
SX_NRST: U2.15 (~RESET); also elsewhere on the board
SX_SPI5_MISO: U2.16 (MISO); also elsewhere on the board
SX_SPI5_MOSI: U2.17 (MOSI); also elsewhere on the board
SX_SPI5_NSS: U2.19 (NSS); also elsewhere on the board
SX_SPI5_SCK: U2.18 (SCK); also elsewhere on the board
VDD1V8: C65.1, U2.11 (VBAT_IO), U10.6 (~CTRL); also elsewhere on the board
VDD3V3: C57.1, C64.1, U2.1 (VDD_IN), U2.10 (VBAT); also elsewhere on the board

Notes on the sheet:
SX1262 915MHz Radio
C486329
C362339
NRESET References VBAT

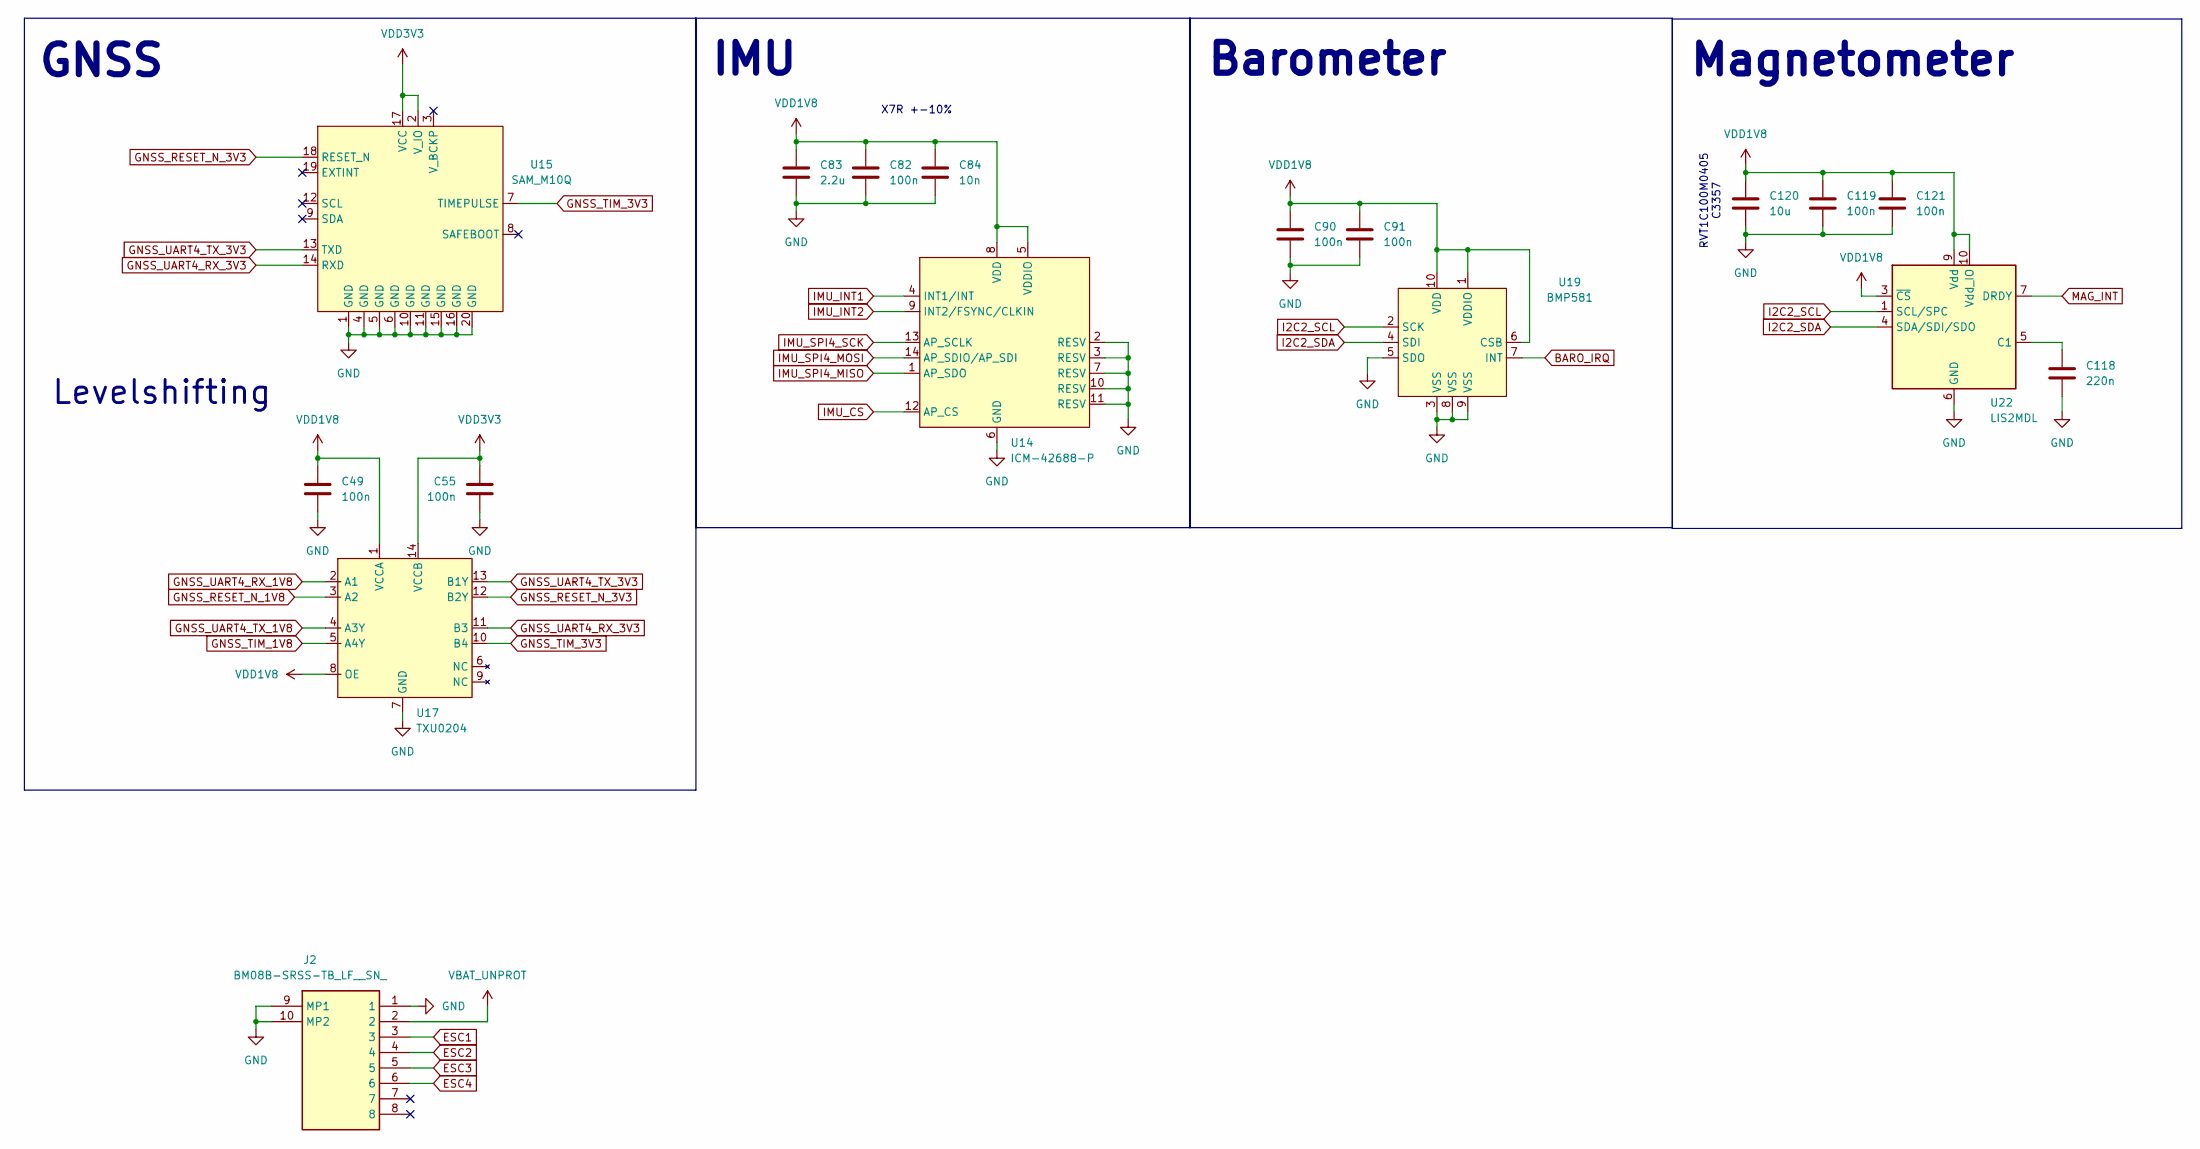
[picture p29: schematic sensors.kicad_sch]

Parts:
C49, C55: 100n; C_0402_1005Metric
C82, C90, C91: 100n; C_0201_0603Metric
C83: 2.2u; C_0402_1005Metric
C84: 10n; C_0201_0603Metric
C118: 220n; C_0603_1608Metric
C119, C121: 100n; C_0603_1608Metric
C120: 10u; CP_Elec_4x5.4
J2: BM08B-SRSS-TB_LF__SN_; BM08BSRSSTBLFSN; Manufacturer_Part_Number BM08B-SRSS-TB(LF)(SN); Mouser Part Number N/A
U14: ICM-42688-P; IIM42352
U15: SAM_M10Q; SAMM10Q
U17: TXU0204; TXU0204BQAR
U19: BMP581
U22: LIS2MDL; LGA-12_2x2mm_P0.5mm

Connections:
BARO_IRQ: U19.7 (INT); also elsewhere on the board
ESC1: J2.3; also elsewhere on the board
ESC2: J2.4; also elsewhere on the board
ESC3: J2.5; also elsewhere on the board
ESC4: J2.6; also elsewhere on the board
GND: C49.2, C55.2, C82.2, C83.2, C84.2, C90.2, C91.2, C118.2, C119.2, C120.2, C121.2, J2.1, J2.9 (MP1), J2.10 (MP2), U14.2 (RESV), U14.3 (RESV), U14.6 (GND), U14.7 (RESV), U14.10 (RESV), U14.11 (RESV), U15.1 (GND), U15.4 (GND), U15.5 (GND), U15.6 (GND), U15.10 (GND), U15.11 (GND), U15.15 (GND), U15.16 (GND), U15.20 (GND), U17.7 (GND), U19.3 (VSS), U19.5 (SDO), U19.8 (VSS), U19.9 (VSS), U22.6 (GND), U22.8 (GND); also elsewhere on the board
GNSS_RESET_N_1V8: U17.3 (A2); also elsewhere on the board
GNSS_RESET_N_3V3: U15.18 (RESET_N), U17.12 (B2Y)
GNSS_TIM_1V8: U17.5 (A4Y); also elsewhere on the board
GNSS_TIM_3V3: U15.7 (TIMEPULSE), U17.10 (B4)
GNSS_UART4_RX_1V8: U17.2 (A1); also elsewhere on the board
GNSS_UART4_RX_3V3: U15.14 (RXD), U17.11 (B3)
GNSS_UART4_TX_1V8: U17.4 (A3Y); also elsewhere on the board
GNSS_UART4_TX_3V3: U15.13 (TXD), U17.13 (B1Y)
I2C2_SCL: U19.2 (SCK), U22.1 (SCL/SPC); also elsewhere on the board
I2C2_SDA: U19.4 (SDI), U22.4 (SDA/SDI/SDO); also elsewhere on the board
IMU_CS: U14.12 (AP_CS); also elsewhere on the board
IMU_INT1: U14.4 (INT1/INT); also elsewhere on the board
IMU_INT2: U14.9 (INT2/FSYNC/CLKIN); also elsewhere on the board
IMU_SPI4_MISO: U14.1 (AP_SDO); also elsewhere on the board
IMU_SPI4_MOSI: U14.14 (AP_SDIO/AP_SDI); also elsewhere on the board
IMU_SPI4_SCK: U14.13 (AP_SCLK); also elsewhere on the board
MAG_INT: U22.7 (DRDY); also elsewhere on the board
unnamed: C118.1, U22.5 (C1)
VBAT_UNPROT: J2.2; also elsewhere on the board
VDD1V8: C49.1, C82.1, C83.1, C84.1, C90.1, C91.1, C119.1, C120.1, C121.1, U14.5 (VDDIO), U14.8 (VDD), U17.1 (VCCA), U17.8 (OE), U19.1 (VDDIO), U19.6 (CSB), U19.10 (VDD), U22.3 (~CS), U22.9 (Vdd), U22.10 (Vdd_IO); also elsewhere on the board
VDD3V3: C55.1, U15.2 (V_IO), U15.17 (VCC), U17.14 (VCCB); also elsewhere on the board

Notes on the sheet:
Levelshifting
X7R +-10%
IMU
RVT1C100M0405 C3357
Barometer
GNSS
Magnetometer

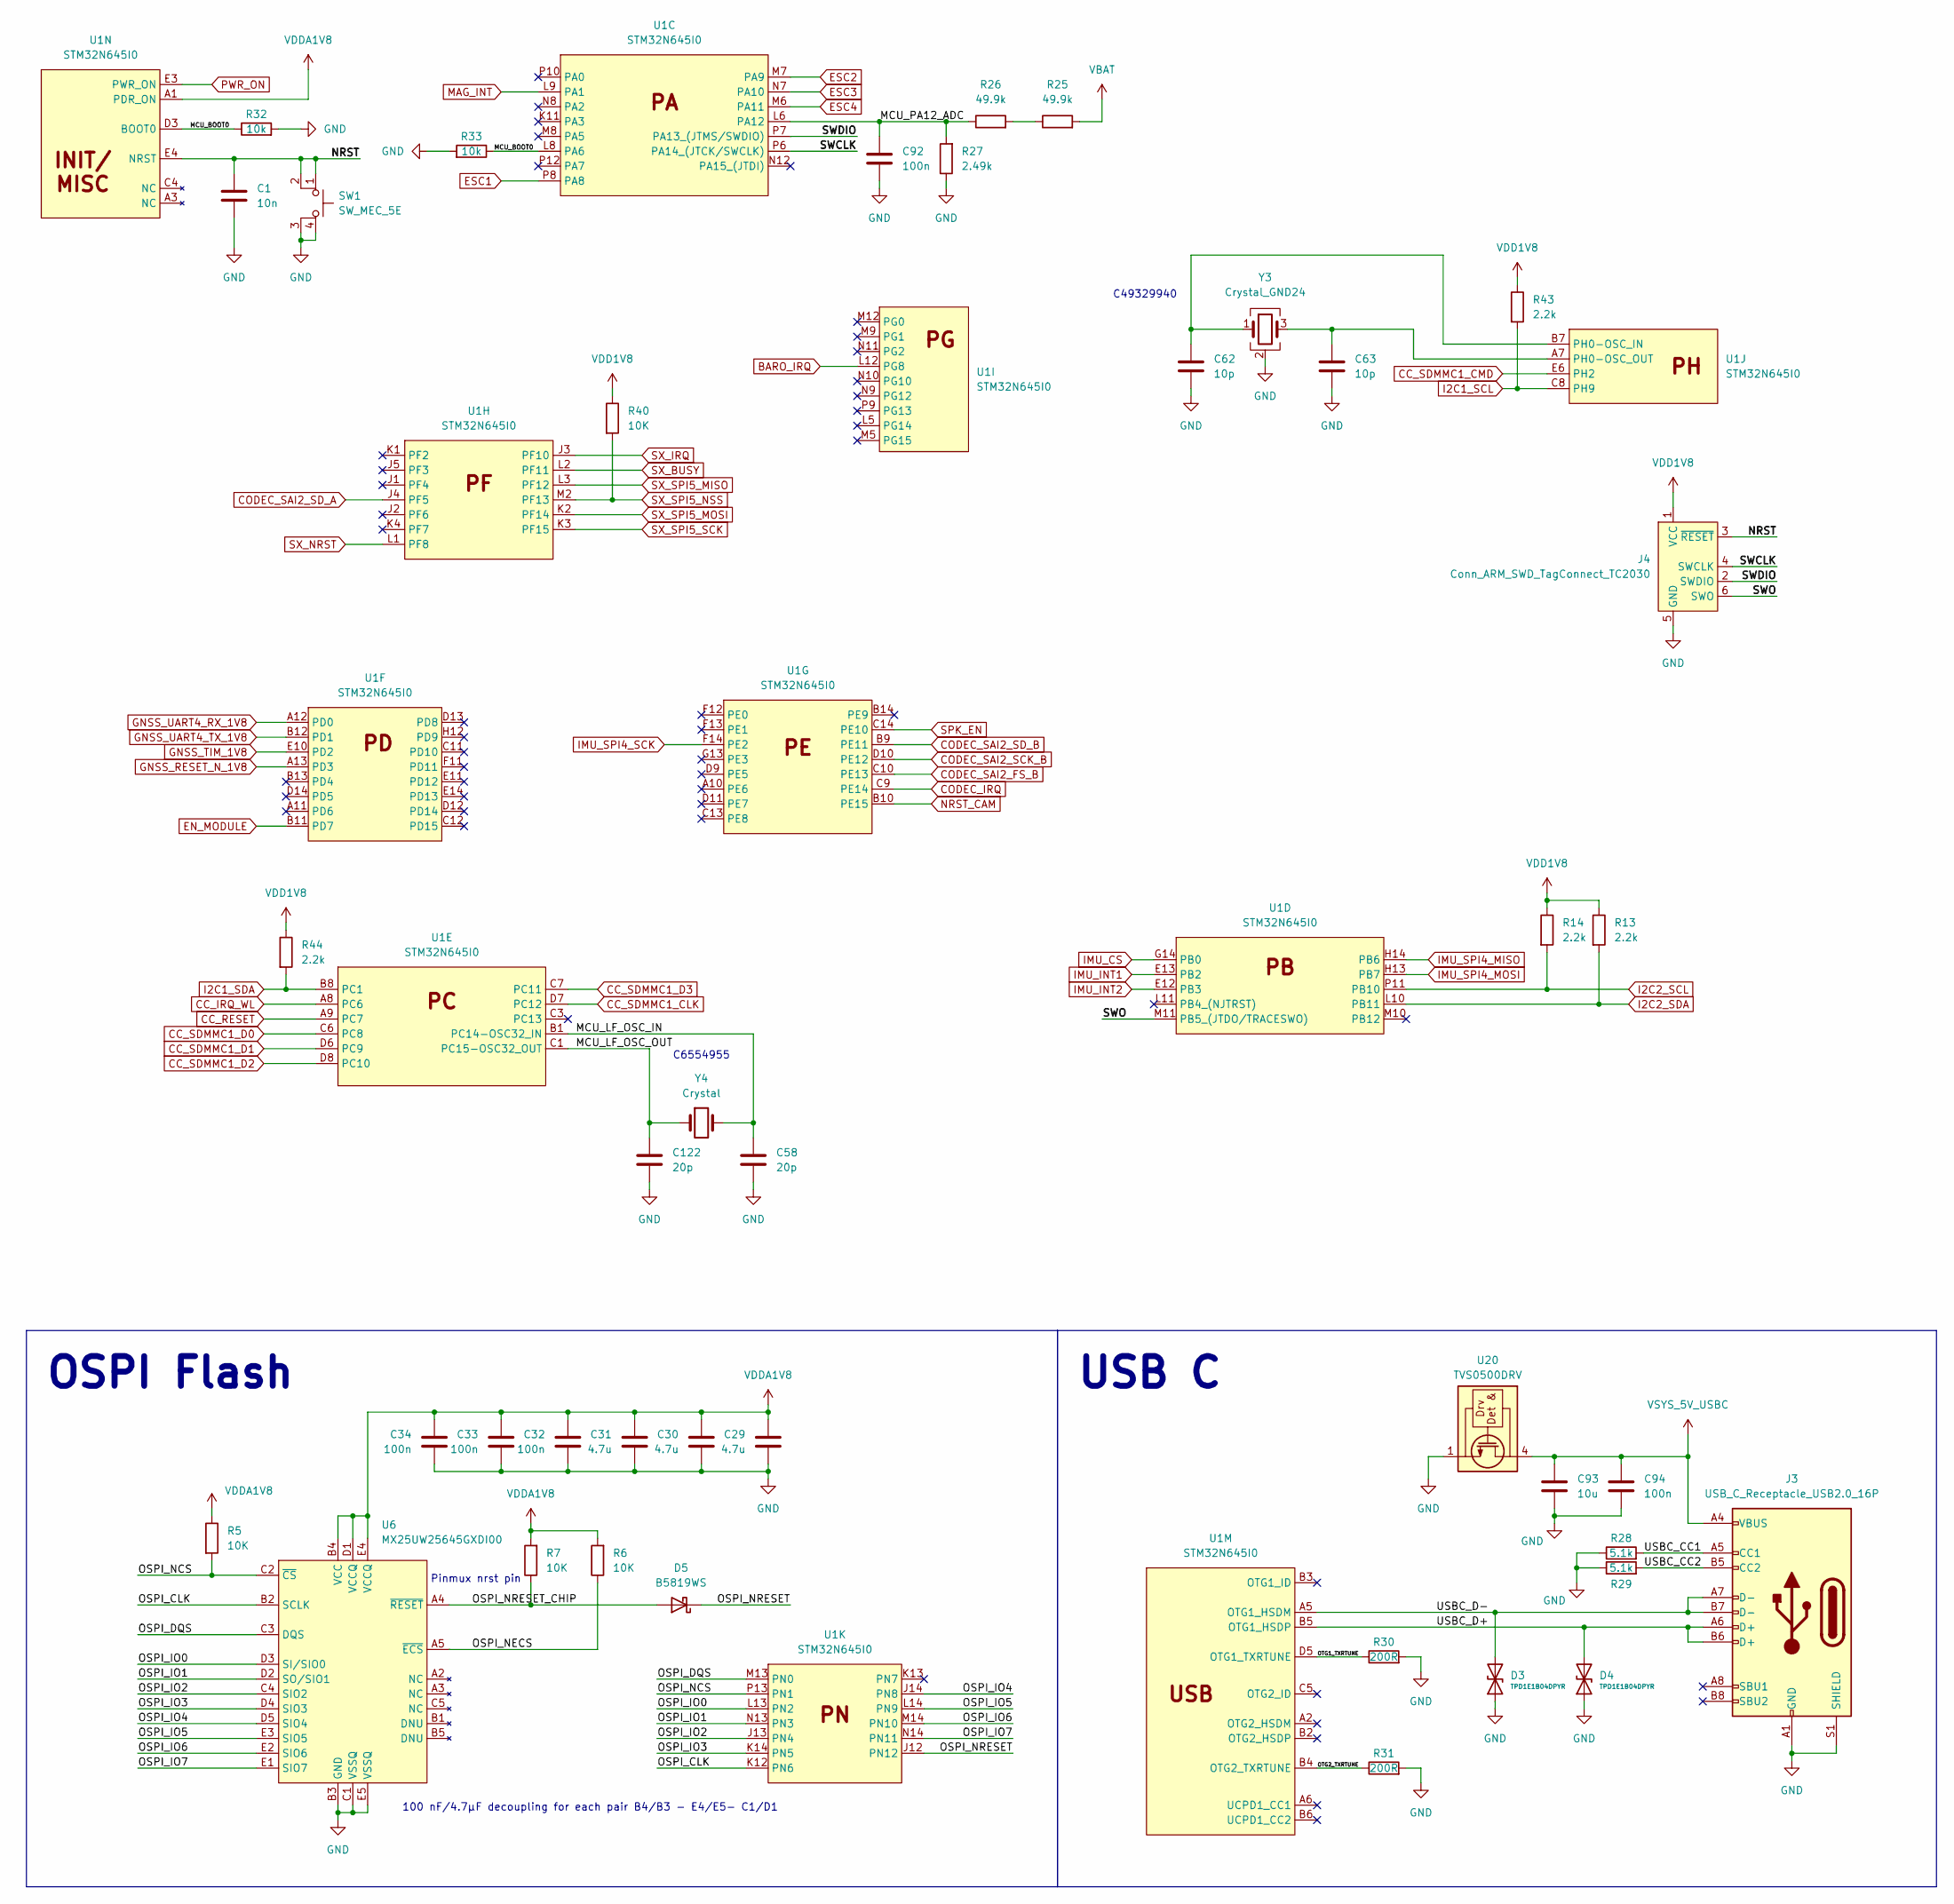
[picture p30: schematic mcu.kicad_sch]

Parts:
C1: 10n; C_0402_1005Metric
C29, C30, C31: 4.7u; C_0603_1608Metric
C32, C33, C34, C94: 100n; C_0402_1005Metric
C58, C122: 20p; C_0201_0603Metric
C62, C63: 10p; C_0201_0603Metric
C92: 100n; C_0603_1608Metric
C93: 10u; C_0805_2012Metric
D3, D4: TPD1E1B04DPYR
D5: B5819WS; D_SOD-323
J3: USB_C_Receptacle_USB2.0_16P; USB_C_Receptacle_HRO_TYPE-C-31-M-12
J4: Conn_ARM_SWD_TagConnect_TC2030; Tag-Connect_TC2030-IDC-FP_2x03_P1.27mm_Vertical
R5, R6, R7, R40: 10K; R_0402_1005Metric
R13, R14, R43, R44: 2.2k; R_0402_1005Metric
R25, R26: 49.9k; R_0603_1608Metric
R27: 2.49k; R_0603_1608Metric
R28, R29: 5.1k; R_0402_1005Metric
R30, R31: 200R; R_0402_1005Metric
R32, R33: 10k; R_0402_1005Metric
SW1: SW_MEC_5E; 1825910-6
U1: STM32N645I0; BGA178C80P14X14_1200X1200X100
U6: MX25UW25645GXDI00; BGA24C100P5X5_600X800X120
U20: TVS0500DRV; WSON-6-1EP_2x2mm_P0.65mm_EP1x1.6mm
Y3: Crystal_GND24; XTM32048000NT00351001
Y4: Crystal; FC-135R 32.7680KA-A3

Connections:
/MCU/MCU_BOOT0: R32.1, R33.1, U1.D3 (BOOT0), U1.L8 (PA6)
/MCU/MCU_LF_OSC_IN: C58.1, U1.B1 (PC14-OSC32_IN), Y4.2
/MCU/MCU_LF_OSC_OUT: C122.1, U1.C1 (PC15-OSC32_OUT), Y4.1
/MCU/MCU_PA12_ADC: C92.1, R26.1, R27.2, U1.L6 (PA12)
/MCU/NRST: C1.1, J4.3 (~RESET), SW1.1, SW1.2, U1.E4 (NRST)
/MCU/OSPI_CLK: U1.K12 (PN6), U6.B2 (SCLK)
/MCU/OSPI_DQS: U1.M13 (PN0), U6.C3 (DQS)
/MCU/OSPI_IO0: U1.L13 (PN2), U6.D3 (SI/SIO0)
/MCU/OSPI_IO1: U1.N13 (PN3), U6.D2 (SO/SIO1)
/MCU/OSPI_IO2: U1.J13 (PN4), U6.C4 (SIO2)
/MCU/OSPI_IO3: U1.K14 (PN5), U6.D4 (SIO3)
/MCU/OSPI_IO4: U1.J14 (PN8), U6.D5 (SIO4)
/MCU/OSPI_IO5: U1.L14 (PN9), U6.E3 (SIO5)
/MCU/OSPI_IO6: U1.M14 (PN10), U6.E2 (SIO6)
/MCU/OSPI_IO7: U1.N14 (PN11), U6.E1 (SIO7)
/MCU/OSPI_NCS: R5.2, U1.P13 (PN1), U6.C2 (~CS)
/MCU/OSPI_NECS: R6.1, U6.A5 (~ECS)
/MCU/OSPI_NRESET: D5.1 (K), U1.J12 (PN12)
/MCU/OSPI_NRESET_CHIP: D5.2 (A), R7.1, U6.A4 (~RESET)
/MCU/OTG1_TXRTUNE: R30.1, U1.D5 (OTG1_TXRTUNE)
/MCU/OTG2_TXRTUNE: R31.1, U1.B4 (OTG2_TXRTUNE)
/MCU/SWCLK: J4.4 (SWCLK), U1.P6 (PA14_(JTCK/SWCLK))
/MCU/SWDIO: J4.2 (SWDIO), U1.P7 (PA13_(JTMS/SWDIO))
/MCU/SWO: J4.6 (SWO), U1.M11 (PB5_(JTDO/TRACESWO))
/MCU/USBC_CC1: J3.A5 (CC1), R28.2
/MCU/USBC_CC2: J3.B5 (CC2), R29.2
/MCU/USBC_D+: D4.2 (A2), J3.A6 (D+), J3.B6 (D+), U1.B5 (OTG1_HSDP)
/MCU/USBC_D-: D3.2 (A2), J3.A7 (D-), J3.B7 (D-), U1.A5 (OTG1_HSDM)
BARO_IRQ: U1.L12 (PG8); also elsewhere on the board
CC_IRQ_WL: U1.A8 (PC6); also elsewhere on the board
CC_RESET: U1.A9 (PC7); also elsewhere on the board
CC_SDMMC1_CLK: U1.D7 (PC12); also elsewhere on the board
CC_SDMMC1_CMD: U1.E6 (PH2); also elsewhere on the board
CC_SDMMC1_D0: U1.C6 (PC8); also elsewhere on the board
CC_SDMMC1_D1: U1.D6 (PC9); also elsewhere on the board
CC_SDMMC1_D2: U1.D8 (PC10); also elsewhere on the board
CC_SDMMC1_D3: U1.C7 (PC11); also elsewhere on the board
CODEC_IRQ: U1.C9 (PE14); also elsewhere on the board
CODEC_SAI2_FS_B: U1.C10 (PE13); also elsewhere on the board
CODEC_SAI2_SCK_B: U1.D10 (PE12); also elsewhere on the board
CODEC_SAI2_SD_A: U1.J4 (PF5); also elsewhere on the board
CODEC_SAI2_SD_B: U1.B9 (PE11); also elsewhere on the board
EN_MODULE: U1.B11 (PD7); also elsewhere on the board
ESC1: U1.P8 (PA8); also elsewhere on the board
ESC2: U1.M7 (PA9); also elsewhere on the board
ESC3: U1.N7 (PA10); also elsewhere on the board
ESC4: U1.M6 (PA11); also elsewhere on the board
GND: C1.2, C29.2, C30.2, C31.2, C32.2, C33.2, C34.2, C58.2, C62.2, C63.2, C92.2, C93.2, C94.2, C122.2, D3.1 (A1), D4.1 (A1), J3.A1 (GND), J3.A12 (GND), J3.B1 (GND), J3.B12 (GND), J3.S1 (SHIELD), J4.5 (GND), R27.1, R28.1, R29.1, R30.2, R31.2, R32.2, R33.2, SW1.3 (K), SW1.4 (A), U6.B3 (GND), U6.C1 (VSSQ), U6.E5 (VSSQ), U20.1 (GND), U20.2 (GND), U20.3 (GND), U20.7 (GND), Y3.2 (G), Y3.4 (G); also elsewhere on the board
GNSS_RESET_N_1V8: U1.A13 (PD3); also elsewhere on the board
GNSS_TIM_1V8: U1.E10 (PD2); also elsewhere on the board
GNSS_UART4_RX_1V8: U1.A12 (PD0); also elsewhere on the board
GNSS_UART4_TX_1V8: U1.B12 (PD1); also elsewhere on the board
I2C1_SCL: R43.2, U1.C8 (PH9); also elsewhere on the board
I2C1_SDA: R44.2, U1.B8 (PC1); also elsewhere on the board
I2C2_SCL: R14.2, U1.P11 (PB10); also elsewhere on the board
I2C2_SDA: R13.2, U1.L10 (PB11); also elsewhere on the board
IMU_CS: U1.G14 (PB0); also elsewhere on the board
IMU_INT1: U1.E13 (PB2); also elsewhere on the board
IMU_INT2: U1.E12 (PB3); also elsewhere on the board
IMU_SPI4_MISO: U1.H14 (PB6); also elsewhere on the board
IMU_SPI4_MOSI: U1.H13 (PB7); also elsewhere on the board
IMU_SPI4_SCK: U1.F14 (PE2); also elsewhere on the board
MAG_INT: U1.L9 (PA1); also elsewhere on the board
NRST_CAM: U1.B10 (PE15); also elsewhere on the board
unnamed: R25.1, R26.2
unnamed: C62.1, U1.B7 (PH0-OSC_IN), Y3.1
unnamed: C63.1, U1.A7 (PH0-OSC_OUT), Y3.3
PWR_ON: U1.E3 (PWR_ON); also elsewhere on the board
SPK_EN: U1.C14 (PE10); also elsewhere on the board
SX_BUSY: U1.L2 (PF11); also elsewhere on the board
SX_IRQ: U1.J3 (PF10); also elsewhere on the board
SX_NRST: U1.L1 (PF8); also elsewhere on the board
SX_SPI5_MISO: U1.L3 (PF12); also elsewhere on the board
SX_SPI5_MOSI: U1.K2 (PF14); also elsewhere on the board
SX_SPI5_NSS: R40.2, U1.M2 (PF13); also elsewhere on the board
SX_SPI5_SCK: U1.K3 (PF15); also elsewhere on the board
VBAT: R25.2; also elsewhere on the board
VDD1V8: J4.1 (VCC), R13.1, R14.1, R40.1, R43.1, R44.1; also elsewhere on the board
VDDA1V8: C29.1, C30.1, C31.1, C32.1, C33.1, C34.1, R5.1, R6.2, R7.2, U1.A1 (PDR_ON), U6.B4 (VCC), U6.D1 (VCCQ), U6.E4 (VCCQ); also elsewhere on the board
VSYS_5V_USBC: C93.1, C94.1, J3.A4 (VBUS), J3.A9 (VBUS), J3.B4 (VBUS), J3.B9 (VBUS), U20.4 (IN), U20.5 (IN), U20.6 (IN); also elsewhere on the board

Notes on the sheet:
OSPI Flash
USB C
100 nF/4.7μF decoupling for each pair B4/B3 - E4/E5- C1/D1
C49329940
C6554955
Pinmux nrst pin
