alexanderjgshort/SoftDrone/hardware/drone/_restore_backup_2026-09-17T12-52-13-706/drone.kicad_pcb

## KiCad design hardware/drone/_restore_backup_2026-09-17T12-52-13-706/drone.kicad_pcb (continued)

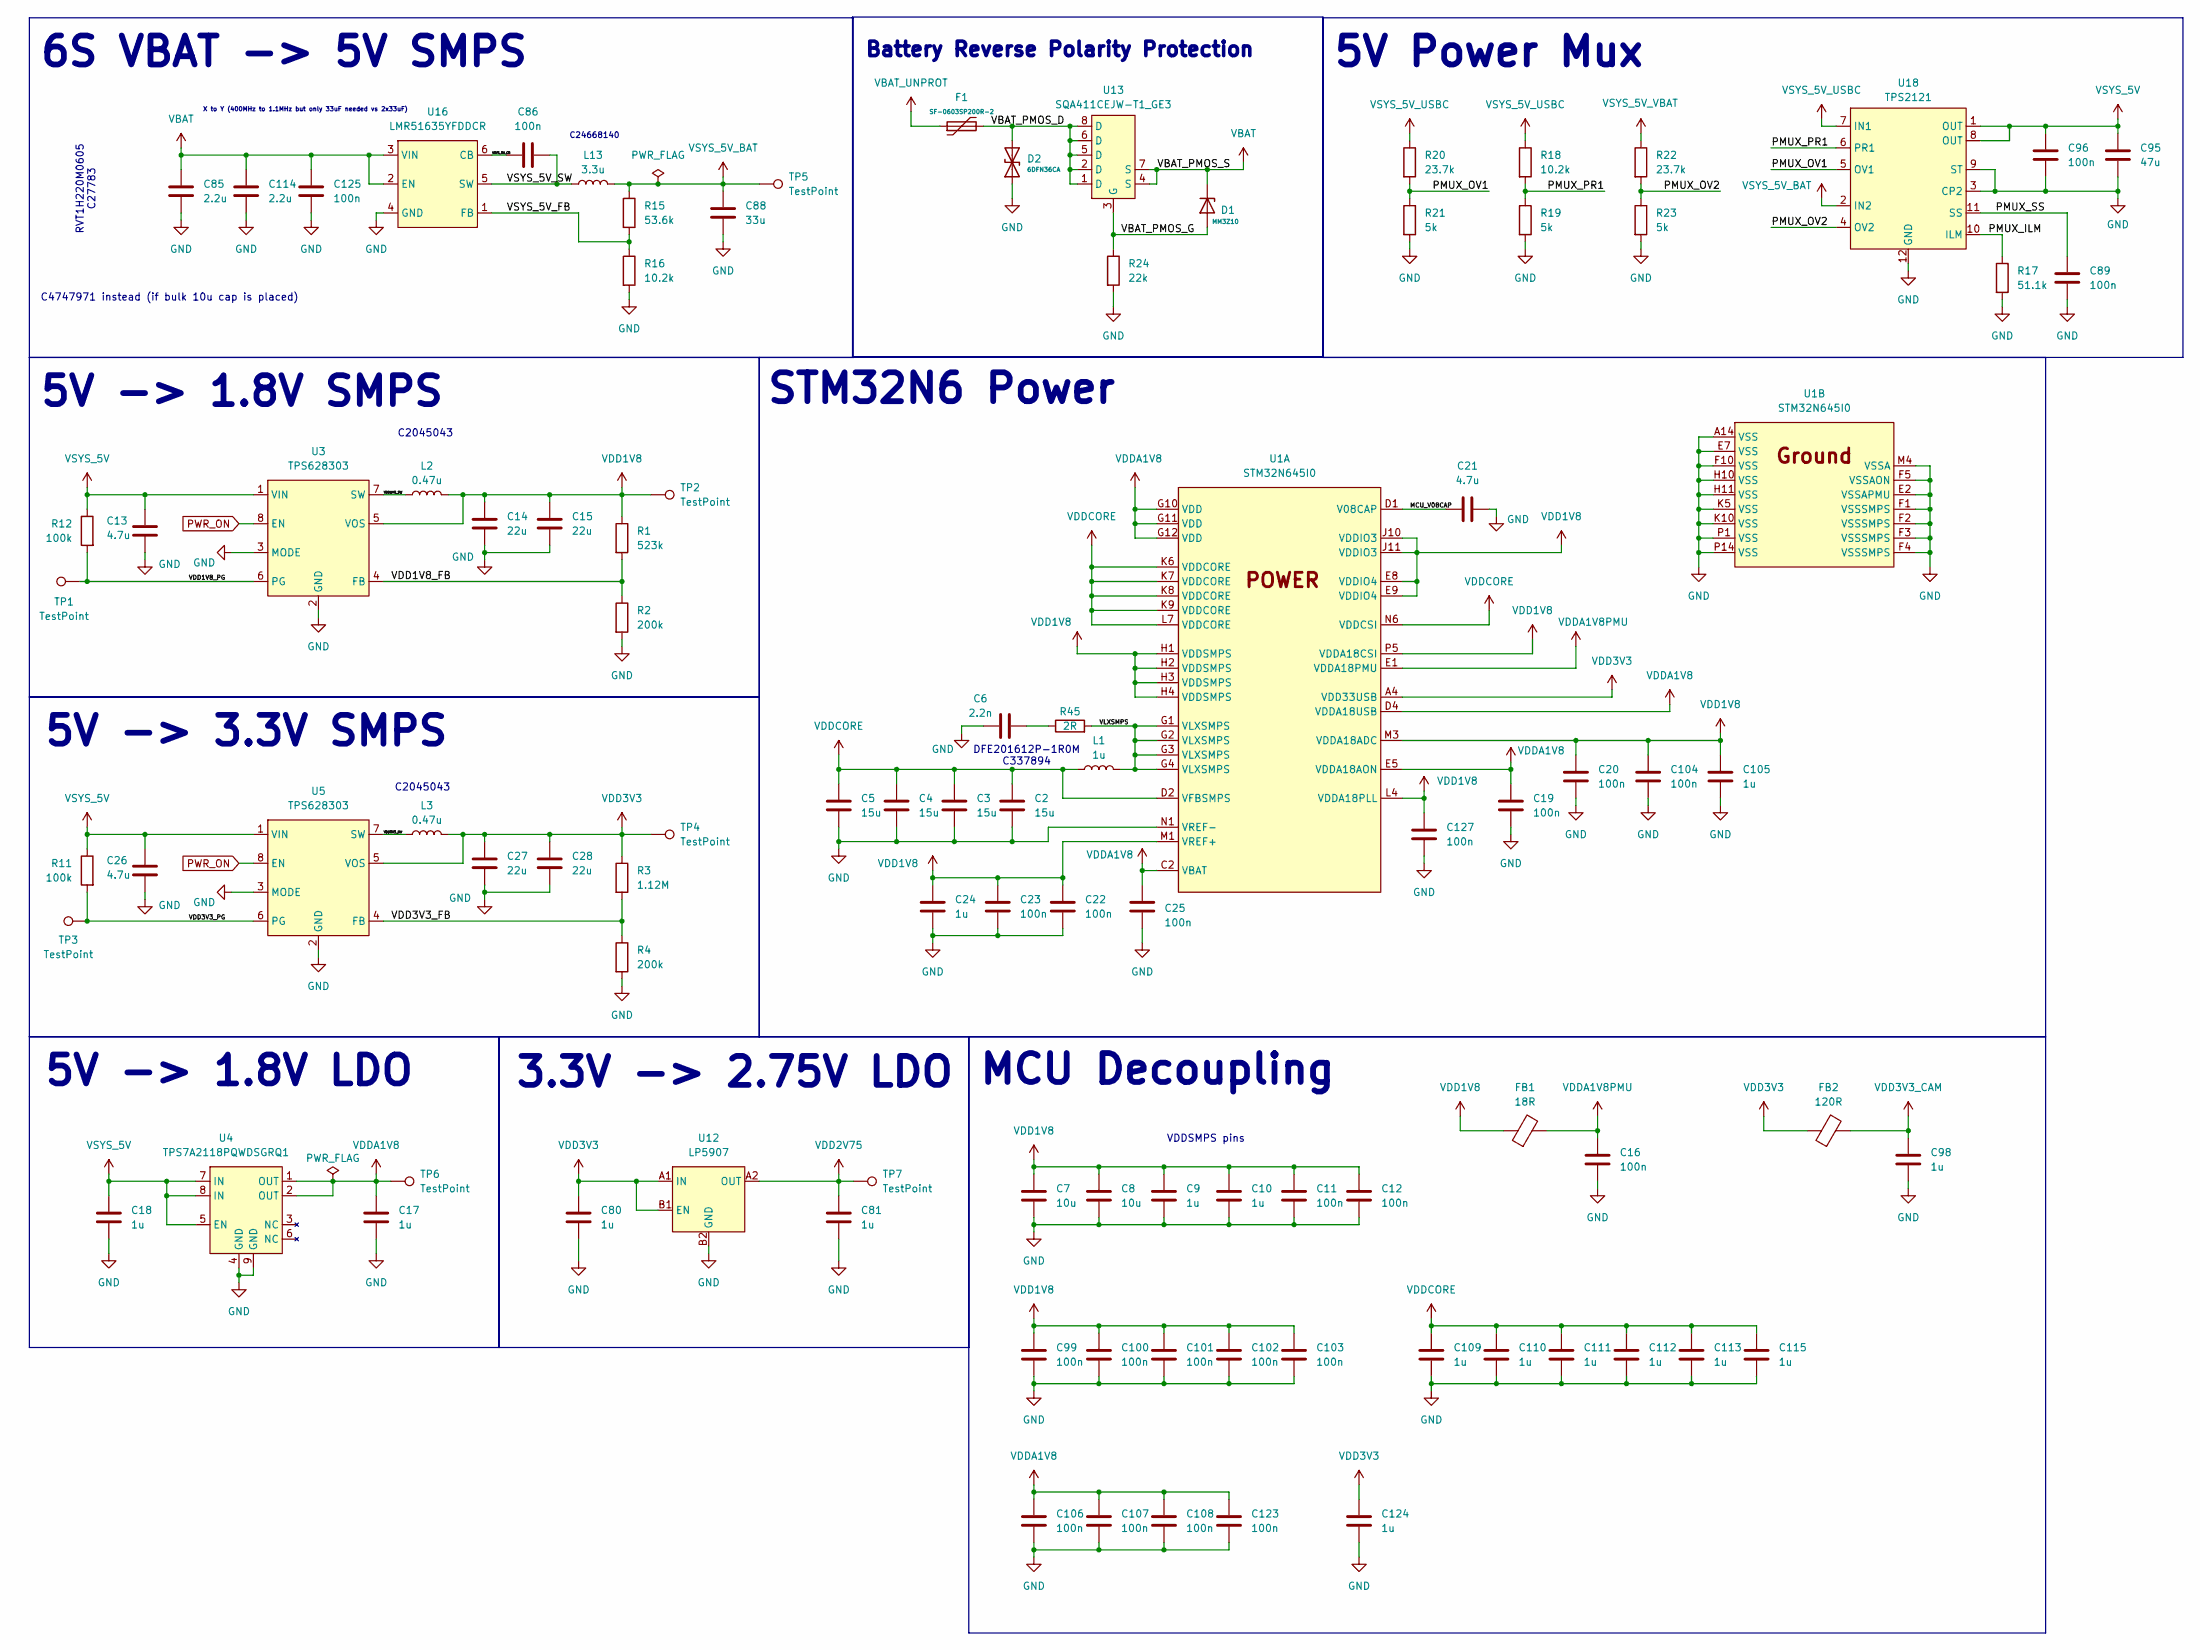
[picture p31: schematic Power.kicad_sch]

Parts:
C2, C3, C4, C5: 15u; C_0603_1608Metric
C6: 2.2n; C_0402_1005Metric
C7, C8: 10u; C_0402_1005Metric
C9, C10, C24, C105, C109, C110, C111, C112, C113, C115: 1u; C_0201_0603Metric
C11, C12, C16, C19, C20, C22, C23, C25, C99, C100, C101, C102, C103, C104, C106, C107, C108, C123, C127: 100n; C_0201_0603Metric
C13, C26: 4.7u; C_0603_1608Metric
C14, C15, C27, C28: 22u; C_0603_1608Metric
C17, C18, C80, C81: 1u; C_0603_1608Metric
C21: 4.7u; C_0402_1005Metric
C85, C114: 2.2u; C_1206_3216Metric
C86, C89, C96, C125: 100n; C_0603_1608Metric
C88: 33u; C_1812_4532Metric
C95: 47u; C_1206_3216Metric
C98, C124: 1u; C_0402_1005Metric
D1: MM3Z10; D_SOD-323
D2: 6DFN36CA; 6DFN12CA
F1: SF-0603SP200R-2; Fuse_0603_1608Metric
FB1: 18R; R_0603_1608Metric
FB2: 120R; R_0402_1005Metric
L1: 1u; CVH201610A-2R2M
L2, L3: 0.47u; TFM201610ALC-R47MTAA
L13: 3.3u; 74439324033
R1: 523k; R_0402_1005Metric
R2, R4: 200k; R_0402_1005Metric
R3: 1.12M; R_0402_1005Metric
R11, R12: 100k; R_0402_1005Metric
R15: 53.6k; R_0603_1608Metric
R16: 10.2k; R_0603_1608Metric
R17: 51.1k; R_0402_1005Metric
R18: 10.2k; R_0402_1005Metric
R19, R21, R23: 5k; R_0402_1005Metric
R20, R22: 23.7k; R_0402_1005Metric
R24: 22k; R_0603_1608Metric
R45: 2R; R_0402_1005Metric
TP1, TP2, TP3, TP4, TP5, TP6, TP7: TestPoint; TestPoint_Pad_2.0x2.0mm
U1: STM32N645I0; BGA178C80P14X14_1200X1200X100
U3, U5: TPS628303; WQFN-HR8_RZE_TEX
U4: TPS7A2118PQWDSGRQ1; Texas_DSG0008A_WSON-8-1EP_2x2mm_P0.5mm_EP0.9x1.6mm
U12: LP5907; BGA4C35P2X2_64X64X50
U13: SQA411CEJW-T1_GE3; SQA411CEJWT1_GE3
U16: LMR51635YFDDCR; SOT-23-6
U18: TPS2121; TPS2121RUXT

Connections:
/Power/MCU_V08CAP: C21.2, U1.D1 (V08CAP)
/Power/PMUX_ILM: R17.1, U18.10 (ILM)
/Power/PMUX_OV1: R20.2, R21.1, U18.5 (OV1)
/Power/PMUX_OV2: R22.2, R23.1, U18.4 (OV2)
/Power/PMUX_PR1: R18.2, R19.1, U18.6 (PR1)
/Power/PMUX_SS: C89.1, U18.11 (SS)
/Power/VBAT_PMOS_D: D2.2 (A2), F1.2, U13.1 (D), U13.2 (D), U13.5 (D), U13.6 (D), U13.8 (D)
/Power/VBAT_PMOS_G: D1.2 (A), R24.1, U13.3 (G)
/Power/VDD1V8_FB: R1.2, R2.1, U3.4 (FB)
/Power/VDD1V8_PG: R12.2, TP1.1 (1_1), U3.6 (PG)
/Power/VDD1V8_SW: L2.1, U3.7 (SW)
/Power/VDD3V3_FB: R3.2, R4.1, U5.4 (FB)
/Power/VDD3V3_PG: R11.2, TP3.1 (1_1), U5.6 (PG)
/Power/VDD3V3_SW: L3.1, U5.7 (SW)
/Power/VLXSMPS: L1.2, R45.2, U1.G1 (VLXSMPS), U1.G2 (VLXSMPS), U1.G3 (VLXSMPS), U1.G4 (VLXSMPS)
/Power/VSYS_5V_CB: C86.1, U16.6 (CB)
/Power/VSYS_5V_FB: R15.2, R16.1, U16.1 (FB)
/Power/VSYS_5V_SW: C86.2, L13.1, U16.5 (SW)
GND: C2.2, C3.2, C4.2, C5.2, C6.1, C7.2, C8.2, C9.2, C10.2, C11.2, C12.2, C13.2, C14.2, C15.2, C16.2, C17.2, C18.2, C19.2, C20.2, C21.1, C22.2, C23.2, C24.2, C25.2, C26.2, C27.2, C28.2, C80.2, C81.2, C85.2, C88.2, C89.2, C95.2, C96.2, C98.2, C99.2, C100.2, C101.2, C102.2, C103.2, C104.2, C105.2, C106.2, C107.2, C108.2, C109.2, C110.2, C111.2, C112.2, C113.2, C114.2, C115.2, C123.2, C124.2, C125.2, C127.2, D2.1 (A1), R2.2, R4.2, R16.2, R17.2, R19.2, R21.2, R23.2, R24.2, U1.A14 (VSS), U1.E2 (VSSAPMU), U1.E7 (VSS), U1.F1 (VSSSMPS), U1.F2 (VSSSMPS), U1.F3 (VSSSMPS), U1.F4 (VSSSMPS), U1.F5 (VSSAON), U1.F10 (VSS), U1.H10 (VSS), U1.H11 (VSS), U1.K5 (VSS), U1.K10 (VSS), U1.M4 (VSSA), U1.N1 (VREF-), U1.P1 (VSS), U1.P14 (VSS), U3.2 (GND), U3.3 (MODE), U4.4 (GND), U4.9 (GND), U5.2 (GND), U5.3 (MODE), U12.B2 (GND), U16.4 (GND), U18.3 (CP2), U18.9 (ST), U18.12 (GND); also elsewhere on the board
unnamed: C6.2, R45.1
PWR_ON: U3.8 (EN), U5.8 (EN); also elsewhere on the board
VBAT: C85.1, C114.1, C125.1, D1.1 (K), U13.4 (S), U13.7 (S), U16.2 (EN), U16.3 (VIN); also elsewhere on the board
VBAT_UNPROT: F1.1; also elsewhere on the board
VDD1V8: C7.1, C8.1, C9.1, C10.1, C11.1, C12.1, C14.1, C15.1, C20.1, C22.1, C23.1, C24.1, C99.1, C100.1, C101.1, C102.1, C103.1, C104.1, C105.1, C127.1, FB1.1, L2.2, R1.1, TP2.1 (1_1), U1.E8 (VDDIO4), U1.E9 (VDDIO4), U1.H1 (VDDSMPS), U1.H2 (VDDSMPS), U1.H3 (VDDSMPS), U1.H4 (VDDSMPS), U1.J10 (VDDIO3), U1.J11 (VDDIO3), U1.L4 (VDDA18PLL), U1.M1 (VREF+), U1.M3 (VDDA18ADC), U1.P5 (VDDA18CSI), U3.5 (VOS); also elsewhere on the board
VDD2V75: C81.1, TP7.1 (1_1), U12.A2 (OUT); also elsewhere on the board
VDD3V3: C27.1, C28.1, C80.1, C124.1, FB2.1, L3.2, R3.1, TP4.1 (1_1), U1.A4 (VDD33USB), U5.5 (VOS), U12.A1 (IN), U12.B1 (EN); also elsewhere on the board
VDD3V3_CAM: C98.1, FB2.2; also elsewhere on the board
VDDA1V8: C17.1, C19.1, C25.1, C106.1, C107.1, C108.1, C123.1, TP6.1 (1_1), U1.C2 (VBAT), U1.D4 (VDDA18USB), U1.E5 (VDDA18AON), U1.G10 (VDD), U1.G11 (VDD), U1.G12 (VDD), U4.1 (OUT), U4.2 (OUT); also elsewhere on the board
VDDA1V8PMU: C16.1, FB1.2, U1.E1 (VDDA18PMU)
VDDCORE: C2.1, C3.1, C4.1, C5.1, C109.1, C110.1, C111.1, C112.1, C113.1, C115.1, L1.1, U1.D2 (VFBSMPS), U1.K6 (VDDCORE), U1.K7 (VDDCORE), U1.K8 (VDDCORE), U1.K9 (VDDCORE), U1.L7 (VDDCORE), U1.N6 (VDDCSI)
VSYS_5V: C13.1, C18.1, C26.1, C95.1, C96.1, R11.1, R12.1, U3.1 (VIN), U4.5 (EN), U4.7 (IN), U4.8 (IN), U5.1 (VIN), U18.1 (OUT), U18.8 (OUT); also elsewhere on the board
VSYS_5V_BAT: C88.1, L13.2, R15.1, TP5.1 (1_1), U18.2 (IN2)
VSYS_5V_USBC: R18.1, R20.1, U18.7 (IN1); also elsewhere on the board
VSYS_5V_VBAT: R22.1

Notes on the sheet:
3.3V -> 2.75V LDO
DFE201612P-1R0M C337894
RVT1H220M0605 C27783
5V -> 1.8V LDO
VDDSMPS pins
C2045043
5V Power Mux
MCU Decoupling
Battery Reverse Polarity Protection
C4747971 instead (if bulk 10u cap is placed)
5V -> 3.3V SMPS
6S VBAT -> 5V SMPS
5V -> 1.8V SMPS
X to Y (400MHz to 1.1MHz but only 33uF needed vs 2x33uF)
C24668140
STM32N6 Power

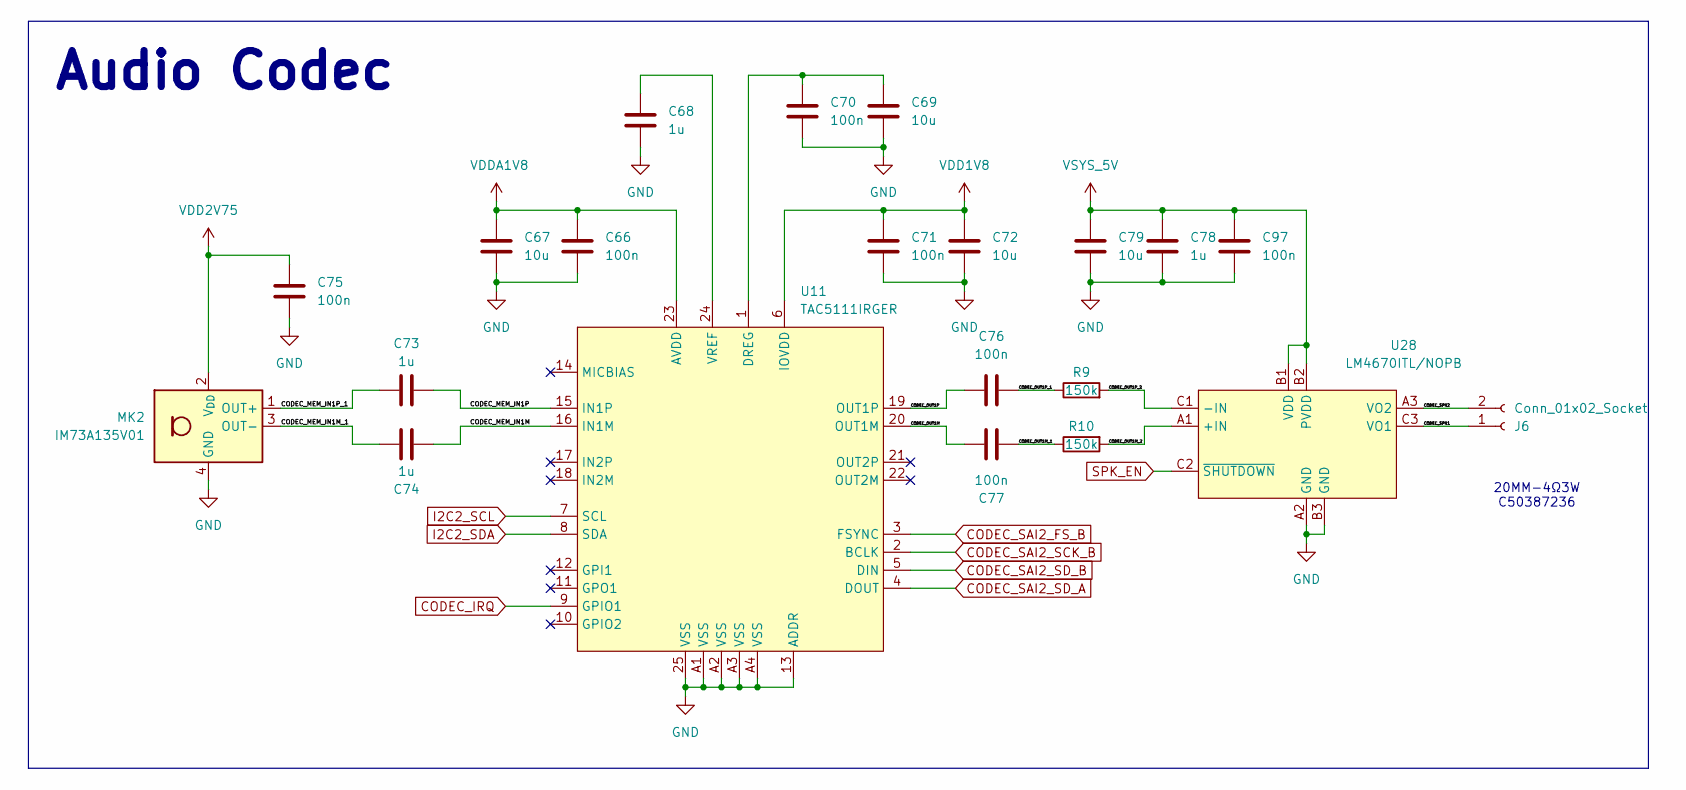
[picture p32: schematic audio.kicad_sch]

Parts:
C66, C70, C71, C75: 100n; C_0402_1005Metric
C67, C69, C72, C79: 10u; C_0805_2012Metric
C68, C73, C74, C78: 1u; C_0603_1608Metric
C76, C77, C97: 100n; C_0603_1608Metric
J6: Conn_01x02_Socket; JST_SH_BM02B-SRSS-TB_1x02-1MP_P1.00mm_Vertical
MK2: IM73A135V01; Infineon_PG-LLGA-5-2
R9, R10: 150k; R_0603_1608Metric
U11: TAC5111IRGER
U28: LM4670ITL/NOPB; BGA9C50P3X3_146X148X68

Connections:
/Audio/CODEC_MEM_IN1M: C74.2, U11.16 (IN1M)
/Audio/CODEC_MEM_IN1M_1: C74.1, MK2.3 (OUT-)
/Audio/CODEC_MEM_IN1P: C73.2, U11.15 (IN1P)
/Audio/CODEC_MEM_IN1P_1: C73.1, MK2.1 (OUT+)
/Audio/CODEC_OUT1M: C77.2, U11.20 (OUT1M)
/Audio/CODEC_OUT1M_1: C77.1, R10.1
/Audio/CODEC_OUT1M_2: R10.2, U28.A1 (+IN)
/Audio/CODEC_OUT1P: C76.1, U11.19 (OUT1P)
/Audio/CODEC_OUT1P_1: C76.2, R9.1
/Audio/CODEC_OUT1P_2: R9.2, U28.C1 (-IN)
/Audio/CODEC_SPK1: J6.1, U28.C3 (VO1)
/Audio/CODEC_SPK2: J6.2, U28.A3 (VO2)
CODEC_IRQ: U11.9 (GPIO1); also elsewhere on the board
CODEC_SAI2_FS_B: U11.3 (FSYNC); also elsewhere on the board
CODEC_SAI2_SCK_B: U11.2 (BCLK); also elsewhere on the board
CODEC_SAI2_SD_A: U11.4 (DOUT); also elsewhere on the board
CODEC_SAI2_SD_B: U11.5 (DIN); also elsewhere on the board
GND: C66.2, C67.2, C68.2, C69.2, C70.2, C71.2, C72.2, C75.1, C78.2, C79.2, C97.2, MK2.4 (GND), MK2.5 (GND), U11.13 (ADDR), U11.25 (VSS), U11.A1 (VSS), U11.A2 (VSS), U11.A3 (VSS), U11.A4 (VSS), U28.A2 (GND), U28.B3 (GND); also elsewhere on the board
I2C2_SCL: U11.7 (SCL); also elsewhere on the board
I2C2_SDA: U11.8 (SDA); also elsewhere on the board
unnamed: C69.1, C70.1, U11.1 (DREG)
unnamed: C68.1, U11.24 (VREF)
SPK_EN: U28.C2 (~SHUTDOWN); also elsewhere on the board
VDD1V8: C71.1, C72.1, U11.6 (IOVDD); also elsewhere on the board
VDD2V75: C75.2, MK2.2 (V_{DD}); also elsewhere on the board
VDDA1V8: C66.1, C67.1, U11.23 (AVDD); also elsewhere on the board
VSYS_5V: C78.1, C79.1, C97.1, U28.B1 (VDD), U28.B2 (PVDD); also elsewhere on the board

Notes on the sheet:
20MM-4Ω3W C50387236
Audio Codec

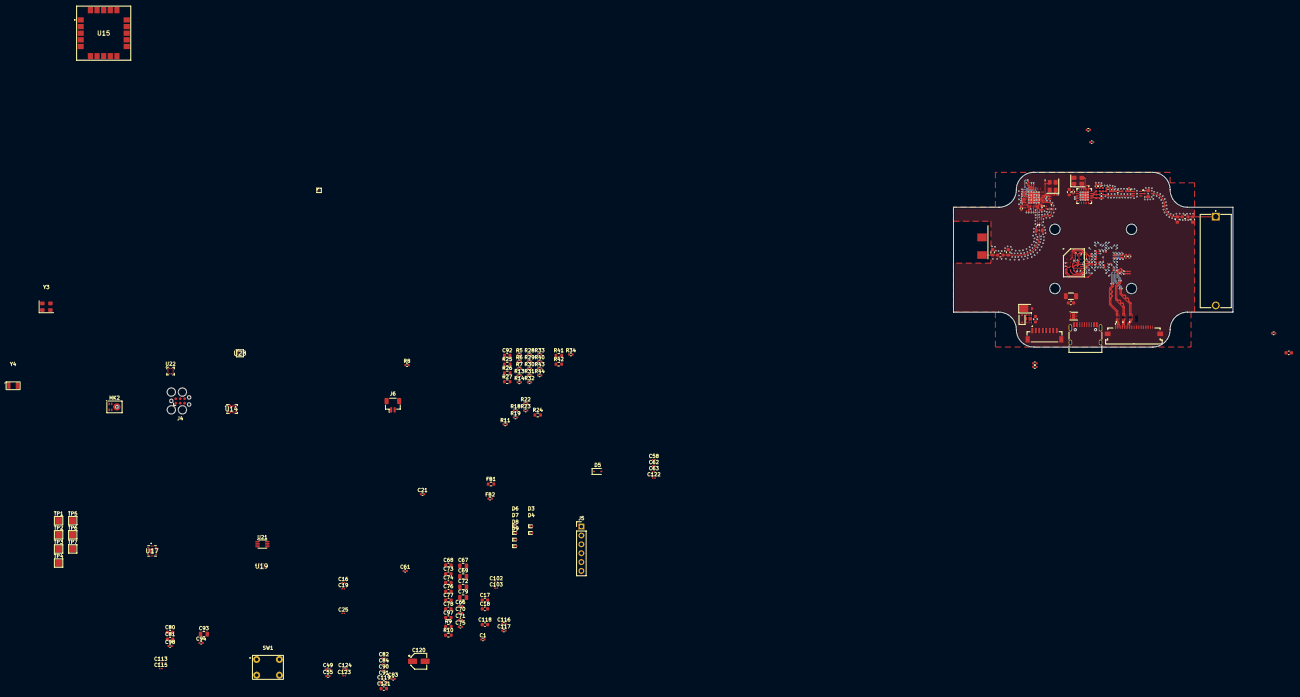
[picture p33: board drone.kicad_pcb from above]

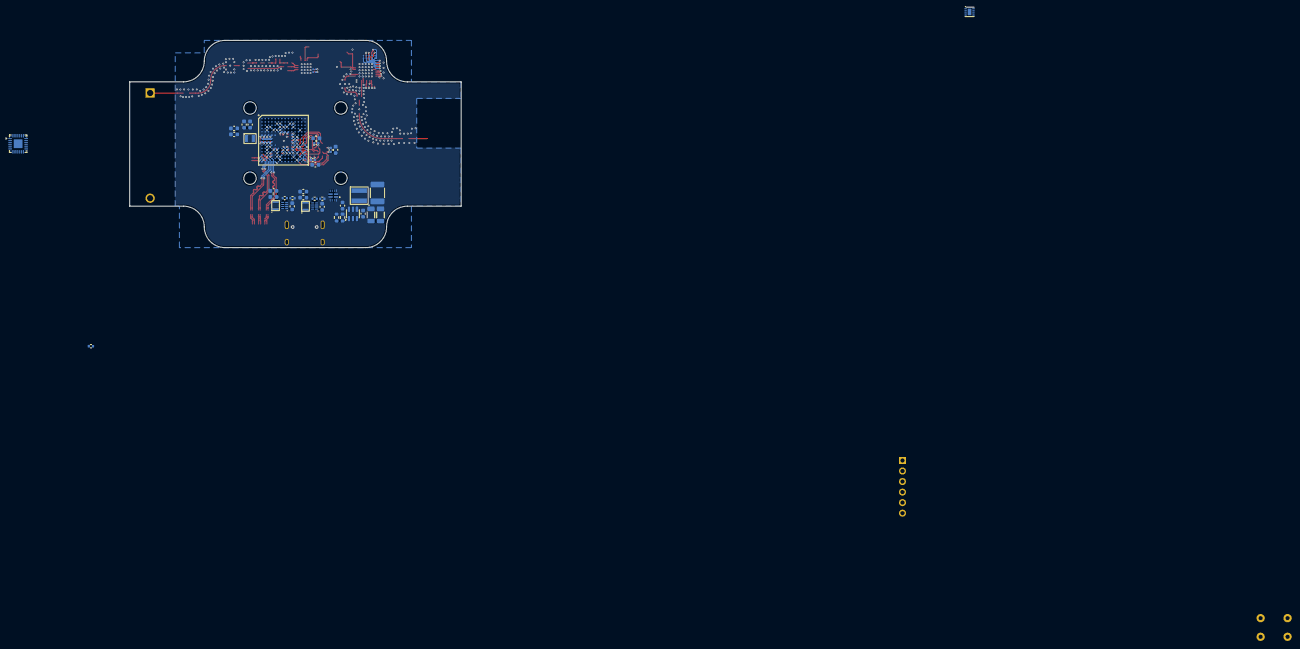
[picture p34: board drone.kicad_pcb from below]

Board: 6 copper layers, 80.0 x 50.0 mm, 244 parts (46 on the bottom side), 172 nets.
