alexanderjgshort/SoftDrone/(commit log)

2026-09-01 Started creating STM32N6 symbol blocks
    [EDI2CAP.CFG, STM32N645I0H3Q.stp, bga178c80p14x14_1200x1200x100.psm, chips.prt, drone.kicad_sch]
2026-09-01 Finished STM32N6 schematic symbol
    [drone.kicad_sch]
2026-09-01 Continued project plan. Started PDN design
    [Power.kicad_sch, audio.kicad_sch, camera.kicad_sch, drone.kicad_pcb, drone.kicad_sch, mcu.kicad_sch, rf_5ghz.kicad_sch, rf_915.kicad_sch]
2026-09-01 Continued PDN and started camera schematic
    [54548-2272.stp, 545482272.psm, EDI2CAP.CFG, Power.kicad_sch, camera.kicad_sch, chips.prt, drone.kicad_pcb]
2026-09-02 More work on power architecture
    [Power.kicad_sch, camera.kicad_sch, mcu.kicad_sch]
2026-09-02 More progress on PDN, picked out OSPI chip
    [EDI2CAP.CFG, MX25UW25645GXDI00-TR.stp, Power.kicad_sch, bga24c100p5x5_600x800x120.psm, chips.prt, mcu.kicad_sch]
2026-09-02 Created symbol for CC3350. Almost finished schematic for OSPI
    [drone.kicad_pcb, mcu.kicad_sch, rf_5ghz.kicad_sch]
2026-09-02 Completed rough schematic of CC3350
    [DPX167125DT-8197B1.stp, EDI2CAP.CFG, chips.prt, dpx167125dt8197b1.psm, rf_5ghz.kicad_sch]
2026-09-02 more radio work
    [Power.kicad_sch, camera.kicad_sch, mcu.kicad_sch, rf_5ghz.kicad_sch, rf_915.kicad_sch]
2026-09-03 Worked on audio schematic (Codec, mic, d class audio amp, speaker)
    [EDI2CAP.CFG, LM4670SD_NOPB.stp, TAC5112IRGER.stp, audio.kicad_sch, chips.prt, son50p300x300x80-9n.psm, tac5112irger.psm]
2026-09-03 Fixed SMPS and LDO sequencing issues
    [Power.kicad_sch, drone.kicad_pcb, mcu.kicad_sch, rf_5ghz.kicad_sch]
2026-09-03 Pinmuxxed codec and picked and completed IMU schematic
    [CC3350ENJARSBR.stp, EDI2CAP.CFG, ICM-42688-P.stp, Power.kicad_sch, audio.kicad_sch, chips.prt, drone.kicad_sch, iim42352.psm]
2026-09-03 Finished GNSS, did more pinmuxxing
    [EDI2CAP.CFG, Power.kicad_sch, SAM-M10Q.stp, audio.kicad_sch, chips.prt, mcu.kicad_sch, rf_5ghz.kicad_sch, rf_915.kicad_sch]
2026-09-04 Implemented power mux to select between battery and usb c 5V
    [Power.kicad_sch, mcu.kicad_sch]
2026-09-04 Added barometer, more pinmuxxing, added VBAT sensing and reverse voltage protection
    [BM08B-SRSS-TB_LF__SN_.stp, BMP581.stp, EDI2CAP.CFG, Power.kicad_sch, audio.kicad_sch, bm08bsrsstblfsn.psm, bmp581.psm, chips.prt]
2026-09-04 Added USB C
    [mcu.kicad_sch]
2026-09-04 Added SWD
    [Power.kicad_sch, drone.kicad_pcb, mcu.kicad_sch, rf_5ghz.kicad_sch, rf_915.kicad_sch]
2026-09-05 Finished MCU schematic decoupling, finished system control schematic
    [Power.kicad_sch, camera.kicad_sch, mcu.kicad_sch, rf_5ghz.kicad_sch, sensors.kicad_sch]
2026-09-05 Fixed BOOT1 pulldown
    [mcu.kicad_sch]
2026-09-06 Created pinmux table and completed pinmuxing
    [Power.kicad_sch, audio.kicad_sch, camera.kicad_sch, mcu.kicad_sch, rf_5ghz.kicad_sch, rf_915.kicad_sch]
2026-09-06 Added magnetometer
    [mcu.kicad_sch, sensors.kicad_sch]
2026-09-06 Small cleanup
    [Power.kicad_sch, audio.kicad_sch, camera.kicad_sch, drone.kicad_pcb, mcu.kicad_sch, rf_5ghz.kicad_sch, rf_915.kicad_sch, sensors.kicad_sch]
2026-09-07 Small cleanup and pinmuxxed OSPI_NRESET
    [Power.kicad_sch, mcu.kicad_sch, rf_5ghz.kicad_sch]
2026-09-07 Added easier RF tuning setup with MM8030
    [EDI2CAP.CFG, MM8030-2610RJ3.stp, chips.prt, mm80302610rj3.psm, rf_5ghz.kicad_sch, rf_915.kicad_sch]
2026-09-07 Fixed some pullups and pinmuxxed more
    [camera.kicad_sch, mcu.kicad_sch, rf_915.kicad_sch, sensors.kicad_sch]
2026-09-07 Fixed i2c pullups
    [mcu.kicad_sch]
2026-09-07 Finished power budget - worst case table
    [Power.kicad_sch, sensors.kicad_sch]
2026-09-07 Moved power and pinmux tables to their own hierarchical sheet
    [Power.kicad_sch, designsummary.kicad_sch, drone.kicad_sch, mcu.kicad_sch]
2026-09-08 Started footprint assignments
    [DEA162450BT-1295A1.stp, EDI2CAP.CFG, PE4259-63.stp, Power.kicad_sch, RZE0008A.stp, audio.kicad_sch, camera.kicad_sch, chips.prt]
2026-09-08 Continued footprint assignments
    [EDI2CAP.CFG, LP5907A28YKMR.stp, Power.kicad_sch, TPS2121RUXT.stp, TXU0204BQAR.stp, audio.kicad_sch, bga4c35p2x2_64x64x50.psm, camera.kicad_sch]
2026-09-08 More footprints
    [ECMF2-40A100N6.stp, EDI2CAP.CFG, Power.kicad_sch, camera.kicad_sch, chips.prt, drone.kicad_pcb, ecmf240a100n6.psm, mcu.kicad_sch]
2026-09-09 Completed footprint assignments
    [ANT-916-HETH.stp, EDI2CAP.CFG, Power.kicad_sch, ant916heth.psm, audio.kicad_sch, chips.prt, drone.kicad_pcb, mcu.kicad_sch]
2026-09-09 Added chip antenna footprint
    [ANT-DB1-NSP250-T.stp, drone.kicad_pcb, rf_5ghz.kicad_sch]
2026-09-10 Labeled nets, added colours, and fixed stm32n6 schematic symbol issues
    [Power.kicad_sch, audio.kicad_sch, camera.kicad_sch, drone.kicad_pcb, mcu.kicad_sch, rf_5ghz.kicad_sch, rf_915.kicad_sch]
2026-09-10 Started layout and tested RF routing paths
    [EDI2CAP.CFG, Power.kicad_sch, SX1262IMLTRT.stp, chips.prt, drone.kicad_pcb, mcu.kicad_sch, qfn50p400x400x100-25n-d.psm, rf_5ghz.kicad_sch]
2026-09-10 Placed SMPS layouts and optimized for space
    [Power.kicad_sch, drone.kicad_pcb]
2026-09-10 Fixed 3D model of antenna
    [ANT-916-HETH.STEP, drone.kicad_pcb]
2026-09-11 Routed OSPI
    [EDI2CAP.CFG, Power.kicad_sch, SQA411CEJW-T1_GE3.stp, camera.kicad_sch, chips.prt, drone.kicad_pcb, rf_915.kicad_sch, sqa411cejwt1_ge3.psm]
2026-09-12 Changed layout and picked new drone chassis
    [F330 low plate - Part 1.step, drone.kicad_pcb]
2026-09-13 Placed connectors and bucks
    [6DFN36CA-M3_I.stp, EDI2CAP.CFG, HRO_TYPE-C-31-M-12.step, Power.kicad_sch, chips.prt, drone.kicad_pcb, sensors.kicad_sch, ss5n42hm3i.psm]
2026-09-13 MCU decap placement and camera connector placement
    [74439324033.psm, 74439324033.stp, EDI2CAP.CFG, Power.kicad_sch, TFM201610ALC-R47MTAA.stp, chips.prt, drone.kicad_pcb, indc2016x80n.psm]
2026-09-13 More decap placement
    [drone.kicad_pcb]
2026-09-14 Routed CC3350 RF, SDMMC, decoupling and crystal
    [drone.kicad_pcb, rf_5ghz.kicad_sch]
2026-09-14 More CC3350 routing
    [drone.kicad_pcb, rf_5ghz.kicad_sch]
2026-09-15 SX1262 layout and decoupling
    [drone.kicad_pcb, rf_915.kicad_sch]
2026-09-16 Routed CSI
    [drone.kicad_pcb]
2026-09-17 Codec layout
    [Power.kicad_sch, audio.kicad_sch, camera.kicad_sch, designsummary.kicad_sch, drone.kicad_pcb, drone.kicad_sch, mcu.kicad_sch, rf_5ghz.kicad_sch]
2026-09-22 Placed and routed IMU
    [drone.kicad_pcb]
2026-09-23 Routed SX1262 SPI and placed decaps for codec
    [audio.kicad_sch, drone.kicad_pcb]
2026-09-24 Crystal routing and sensor placement
    [EDI2CAP.CFG, FC-135R_32.7680KA-A3.stp, chips.prt, drone.kicad_pcb, fc135r327680kaa3.psm]
2026-09-28 Fixed SPI routing around crystals and MCU SMPS
    [drone.kicad_pcb]
2026-09-28 fixed sub ghz rf front end layout
    [drone.kicad_pcb]
2026-09-29 Started power routing
    [drone.kicad_pcb, rf_915.kicad_sch]
2026-09-29 More power routing
    [Power.kicad_sch, drone.kicad_pcb]
2026-09-29 Added power mux input decoupling
    [Power.kicad_sch, drone.kicad_pcb]
2026-10-01 Small cleanup and more power routing
    [Power.kicad_sch, drone.kicad_pcb, mcu.kicad_sch, rf_5ghz.kicad_sch, rf_915.kicad_sch]
2026-10-02 More power routing. Switched to STM32N657 due to product availability
    [drone.kicad_pcb]
2026-10-08 more power layout
    [EDI2CAP.CFG, SON65P300X300X100-9N-D.PcbLib, TPS7A2118PQWDRBRQ1.SchLib, TPS7A2118PQWDRBRQ1.stp, chips.prt, drone.kicad_pcb, mcu.kicad_sch, rf_915.kicad_sch]
2026-10-14 Schematic cleanup and changed pi network footprints
